ojousima/thesis/thesis.tex

%%%%%%%%%%%%%%%%%%%%%%%%%%%%%%%%%%%%%%%%%%%%%%%%%%%%%%%%%%%%%%%%%%%%
%%%%%%%%%%%%%%%%%%%%%%%%%%%%%%%%%%%%%%%%%%%%%%%%%%%%%%%%%%%%%%%%%%%%
%%                                                                %%
%% An example for writting your thesis using LaTeX                %%
%% Original version by Luis Costa,  changes by Perttu Puska       %%
%% Support for Swedish added 15092014                             %%
%%                                                                %%
%% This example consists of the files                             %%
%%         thesistemplate.tex (versio 2.01)                       %%
%%         opinnaytepohja.tex (versio 2.01) (for text in Finnish) %%
%%         aaltothesis.cls (versio 2.01)                          %%
%%         kuva1.eps                                              %%
%%         kuva2.eps                                              %%
%%         kuva1.pdf                                              %%
%%         kuva2.pdf                                              %%
%%                                                                %%
%%                                                                %%
%% Typeset either with                                            %%
%% latex:                                                         %%
%%             $ latex opinnaytepohja                             %%
%%             $ latex opinnaytepohja                             %%
%%                                                                %%
%%   Result is the file opinnayte.dvi, which                      %%
%%   is converted to ps format as follows:                        %%
%%                                                                %%
%%             $ dvips opinnaytepohja -o                          %%
%%                                                                %%
%%   and then to pdf as follows:                                  %%
%%                                                                %%
%%             $ ps2pdf opinnaytepohja.ps                         %%
%%                                                                %%
%% Or                                                             %%
%% pdflatex:                                                      %%
%%             $ pdflatex opinnaytepohja                          %%
%%             $ pdflatex opinnaytepohja                          %%
%%                                                                %%
%%   Result is the file opinnaytepohja.pdf                        %%
%%                                                                %%
%% Explanatory comments in this example begin with                %%
%% the characters %%, and changes that the user can make          %%
%% with the character %                                           %%
%%                                                                %%
%%%%%%%%%%%%%%%%%%%%%%%%%%%%%%%%%%%%%%%%%%%%%%%%%%%%%%%%%%%%%%%%%%%%
%%%%%%%%%%%%%%%%%%%%%%%%%%%%%%%%%%%%%%%%%%%%%%%%%%%%%%%%%%%%%%%%%%%%

%% Uncomment one of these:
%% the 1st when using pdflatex, which directly typesets your document in
%% pdf (use jpg or pdf figures), or
%% the 2nd when producing a ps file (use eps figures, don't use ps figures!).
\documentclass[english,12pt,a4paper,pdftex,elec,utf8]{aaltothesis}
%\documentclass[english,12pt,a4paper,dvips]{aaltothesis}

%% To the \documentclass above
%% specify your school: arts, biz, chem, elec, eng, sci
%% specify the character encoding scheme used by your editor: utf8, latin1

%% Use one of these if you write in Finnish (see the Finnish template):
%%
%\documentclass[finnish,12pt,a4paper,pdftex,elec,utf8]{aaltothesis}
%\documentclass[finnish,12pt,a4paper,dvips]{aaltothesis}

\usepackage{graphicx}

%% Use this if you write hard core mathematics, these are usually needed
\usepackage{amsfonts,amssymb,amsbsy}

%includes amsmath for EQREF
\usepackage{mathtools}

%% Use the macros in this package to change how the hyperref package below 
%% typesets its hypertext -- hyperlink colour, font, etc. See the package
%% documentation. It also defines the \url macro, so use the package when 
%% not using the hyperref package.
%%
%\usepackage{url}

%% Use this if you want to get links and nice output. Works well with pdflatex.
\usepackage{hyperref}
\hypersetup{pdfpagemode=UseNone, pdfstartview=FitH,
  colorlinks=true,urlcolor=black,linkcolor=black,citecolor=black,
  pdftitle={Energy Harvester Design for Intelligent Tyre Systems},pdfauthor={Otso Jousimaa},
  pdfkeywords={Modify keywords}}

%Use for degree symbol
\usepackage{gensymb}

%for color
\usepackage{color}

%for block comments
\usepackage{verbatim}

%for sub/superscripts
\usepackage{fixltx2e}

%for multi-citations
\usepackage{cite}

%% All that is printed on paper starts here
\begin{document}

%% Change the school field to specify your school if the automatically 
%% set name is wrong
% \university{aalto-yliopisto}
\university{Aalto University}
% \school{Sähkötekniikan korkeakoulu}
\school{School of Electrical Engineering}

%% Only for B.Sc. thesis: Choose your degree programme. 
%\degreeprogram{Electronics and electrical engineering}
%%

%% ONLY FOR M.Sc. AND LICENTIATE THESIS: Specify your department,
%% professorship and professorship code. 
%%
\department{Department of Electrical Engineering and Automation}
\professorship{Automation technology \hfill Code: AS-84}
%%

%% Valitse yksi näistä kolmesta
%%
%% Choose one of these:
%\univdegree{BSc}
\univdegree{MSc}
%\univdegree{Lic}

%% Your own name (should be self explanatory...)
\author{Otso Jousimaa}

%% Your thesis title comes here and again before a possible abstract in
%% Finnish or Swedish . If the title is very long and latex does an
%% unsatisfactory job of breaking the lines, you will have to force a
%% linebreak with the \\ control character. 
%% Do not hyphenate titles.
%% 
\thesistitle{Energy Harvester Design for Intelligent Tyre Systems}

\place{Espoo}

%% For B.Sc. thesis use the date when you present your thesis. 
%% 
%% Kandidaatintyön päivämäärä on sen esityspäivämäärä! 
\date{14.03.2016}

%% B.Sc. or M.Sc. thesis supervisor 
%% Note the "\" after the comma. This forces the following space to be 
%% a normal interword space, not the space that starts a new sentence. 
%% This is done because the fullstop isn't the end of the sentence that
%% should be followed by a slightly longer space but is to be followed
%% by a regular space.
%%
\supervisor{Prof.\ Arto Visala}

%% B.Sc. or M.Sc. thesis advisors(s). You can give upto two advisors in
%% this template. Check with your supervisor how many official advisors
%% you can have.
%%
%\advisor{Prof.\ Pirjo Professori}
\advisor{M.Sc.\ Yi Xiong}
\advisor{D.Sc.\ (Tech.) Ari Tuononen}

%% Aalto logo: syntax:
%% \uselogo{aaltoRed|aaltoBlue|aaltoYellow|aaltoGray|aaltoGrayScale}{?|!|''}
%%
%% Logo language is set to be the same as the document language.
%% Logon kieli on sama kuin dokumentin kieli
%%
\uselogo{aaltoRed}{''}

%% Create the coverpage
%%
\makecoverpage

%% Note that when writting your master's thesis in English, place
%% the English abstract first followed by the possible Finnish abstract

%% English abstract.
%% All the information required in the abstract (your name, thesis title, etc.)
%% is used as specified above.
%% Specify keywords
%%
%% Kaikki tiivistelmässä tarvittava tieto (nimesi, työnnimi, jne.) käytetään
%% niin kuin se on yllä määritelty.
%% Avainsanat
%%
\keywords{Energy harvesting, tyre sensors, active safety systems}
%% Abstract text
\begin{abstractpage}[english]
Modern tyres can have sensor systems which require energy. Currently these systems are powered by batteries, which limit the power available and lifetime of the systems. This study presents an energy harvester system to power such sensor systems. Piezoelectric and electromagnetic harvester designs are 
presented and the piezoelectric harvester design was selected for use in the tyre. Electrical energy was harvested from tyre rotation and deformation, harvested power was rectified and stored into a supercapacitor at a voltage level usable by modern microcontrollers. Tens of milliwatts of electrical power was obtained from both harvesters in a vibration exciter test setup, and the piezoelectric harvester produced 13 microwatts of electrical power in a chassis dynamometer test rig. Further testing indicates 50 microwatts of power is obtainable at a higher speed of the tyre. The power obtained from harvester exceeds sleep mode power requirement of sensor system, and the sensor system could be theoretically operated intermittently with the power available from harvester. Continuous operation of a sensor system is not feasible with the presented harvester.
\end{abstractpage}

%% Force a new page so that the possible English abstract starts on a new page
%%
%% Pakotetaan uusi sivu varmuuden vuoksi, jotta 
%% mahdollinen suomenkielinen ja englanninkielinen tiivistelmä
%% eivät tule vahingossakaan samalle sivulle
\newpage
%
%% Abstract in Finnish.  Delete if you don't need it. 
\thesistitle{Energy Harvester Design for Intelligent Tire Systems}
\advisor{DI Yi Xiong}
\advisor{TkT Ari Tuononen}
\degreeprogram{Automaatio- ja systeemitekniikka}
\department{Sähkötekniikan ja automaation laitos}
\professorship{Automaatiotekniikka \hfill Koodi: AS-84}
%% Avainsanat
\keywords{Energian harvestointi, rengasanturit, aktiiviset turvajärjestelmät}
%% Tiivistelmän tekstiosa
\begin{abstractpage}[finnish]
Moderneissa renkaissa voi olla anturijärjestelmiä jotka tarvitsevat energiaa. Nykyään nämä järjestelmät saavat tehonsa pattereista, mikä 
rajoittaa käytettävissä olevaa tehoa ja järjestelmän käyttöaikaa.
Tässä työssä esitetään energianharvestointijärjestelmä rengasantureiden tarpeisiin.  

Työssä esitetään pietsosähköinen ja sähkömagneettinen harvesteri, joista pietsosähköinen harvesteri todettiin paremmin renkaaseen soveltuvaksi. Sähköistä energiaa kerättiin renkaan pyörimisliikkeestä ja muodonmuutoksista. Kerätty energia tasasuunnattiin ja varastoitiin superkapasitoriin modernille mikrokontrollerille soveltuvalla jännitetasolla. Molemmat harvesterit tuottivat kymmeniä milliwatteja tärinägeneraattorilla testattuna ja pietsosähköinen harvesteri tuotti 13 mikrowattia dynamometrialustalla. Myöhempi testaus ennustaa että pietsosähköinen generaattori voisi tuottaa 50 mikrowattia tehoa korkeammilla rengasnopeuksilla. 

Harvesterista saatu teho ylittää anturijärjestelmän lepovirran kulutuksen, ja anturijärjestelmää voisi teoriassa käyttää jaksottaisesti käytettävissä olevalla teholla. Anturijärjestelmän jatkuva käyttäminen ei ole mahdollista tässä työssä esitetyllä harvesterilla. 
\end{abstractpage}

%% Preface
%%
%% Esipuhe 
\mysection{Preface}
%\mysection{Esipuhe}
This research was carried out in the Laboratory of Vehicle Technology, Aalto University School of Engineering during 2015-2016. 
Some sections of the work relating to piezoelectric harvester and electronics design have been used as a basis for IEEE Intelligent Vehicles Symposium 2016 
conference paper pending peer review.   

I am deeply grateful for my thesis instructors M.Sc Yi Xiong and D.Sc Ari Tuononen for their encouragement, guidance and patience in all phases of the work. 
Special thanks go to my supervisor Prof. Arto Visala for his confidence in me and my supervisors during the work. 

I would like to express my gratitude to Daniel Edwards, Lauri Jämsä, Tero Kapanen, Gaja Kochaniewicz, Martti Paalanen, Markku Rouvala and Heikki Salminen for providing insights in use cases, manufacturing methods, soundness of various ideas and textual clarity for the work.  

The work was financially supported by Henry Ford S\"a\"ati\"o

\vspace{5cm}
Otaniemi, 14.03.2016

\vspace{5mm}
{\hfill Otso J. Jousimaa \hspace{1cm}}

%% Force new page after preface
%%
%% Pakotetaan varmuuden vuoksi esipuheen jälkeinen osa
%% alkamaan uudelta sivulta
\newpage

%% Table of contents. 
\thesistableofcontents

%% Symbols and abbreviations
\mysection{Symbols and abbreviations}

\subsection*{Symbols}

\begin{tabular}{ll}
$\mathbf{A}$  & area \\
$\mathbf{B}$  & magnetic flux density  \\
$\varepsilon$ & electromotive force \\
$\mathbf{F}$  & mechanical force \\
g             & gram \\
$g$           & acceleration of falling \\ 
gf            & gram-force \\
$\mathbf{I}$  & electrical current \\
$\mathbf{l}$  & length \\
$\Phi_{B}$    & magnetic flux through a loop area \\
$\rho$        & resistivity \\
$\mathbf{P}$  & power \\
$\mathbf{p}$  & pressure \\
$\mathbf{U}$  & input to system \\
$\mathbf{V}$  & voltage \\
$\mathbf{Y}$  & output from system \\
$\mathbf{Z}$  & complex impedance
\end{tabular}

\subsection*{Abbreviations}

\begin{tabular}{ll}
AC         & Alternating Current \\
BLE        & Bluetooth Low Energy \\
DC         & Direct Current \\
EMF        & Electromotive Force \\
FEA        & Finite Element Analysis \\
I2C        & Inter-Integrated Circuit \\
IC         & Integrated Circuit \\
LG         & Linear Generator \\
MEMS       & Microelectromechanical Systems \\
MOSFET     & Metal–Oxide–Semiconductor Field-Effect Transistor \\
MPPT       & Maximum Power Point Tracking \\
PV         & Photovoltaic \\
RF         & Radio Frequency \\
SPI        & Serial Peripheral Interface \\
SMPS       & Switch-Mode Power Supply \\
TPMS       & Tyre Pressure Monitoring Sensor \\
UART       & Universal Asynchronous Receiver/Transmitter
\end{tabular}

%% Tweaks the page numbering to meet the requirement of the thesis format:
%% Begin the pagenumbering in Arabian numerals (and leave the first page
%% of the text body empty, see \thispagestyle{empty} below).
%% Additionally, force the actual text to begin on a new page with the 
%% \clearpage command.
%% \clearpage is similar to \newpage, but it also flushes the floats (figures
%% and tables).
%% There is no need to change these
%%
\cleardoublepage
\storeinipagenumber
\pagenumbering{arabic}
\setcounter{page}{1}

%% Text body begins. Note that since the text body
%% is mostly in Finnish the majority of comments are
%% also in Finnish after this point. There is no point in explaining
%% Finnish-language specific thesis conventions in English. Someday 
%% this text will possibly be translated to English.
%%
%\section{Introduction}
\input{introduction.tex}

%\section{Background}
%% In a thesis, every section starts a new page, hence \clearpage
\clearpage
\input{background.tex}

%\section{Literature review?}
%\input{Literature review?}

%\section{Design} Theoretical
\clearpage
\input{design.tex}

%\section{Results} Practical
\clearpage
\input{results.tex}

%\section{Conclusions}
\clearpage
\input{conclusions.tex}

%% L\"ahdeluettelo
%%
%% \phantomsection varmistaa, ett\"a hyperref-paketti latoo hypertekstilinkit
%% oikein.
%%
%% The \phantomsection command is nessesary for hyperref to jump to the 
%% correct page, in other words it puts a hyper marker on the page.
\clearpage
\phantomsection
\addcontentsline{toc}{section}{\refname}
%\addcontentsline{toc}{section}{References}
\bibliography{library}
\bibliographystyle{IEEEtran}

%% Appendices
%% Liitteet
\clearpage

\thesisappendix

\end{document}
