ojousima/thesis/hardware/BQ25504/bq25504_Design_Help_V1_2.ods

User Input | VBIAS | 1.25 | V
Fixed
 | Comparator threshold for VSTOR maximum. |  |  |  |  | Comparator threshold voltages indicating when |  |  |  |  | Comparator threshold for VSTOR minimum. |  |  |  |  | Maximum power point threshold, e.g. ~0.7-0.8 of
 | Typically the max storage element voltage, |  |  |  |  | VSTOR has risen above VBAT_OK_HYS or fallen |  |  |  |  | Typically the min storage element voltage, |  |  |  |  | solar panel's open circuit voltage
 | e.g. 4.2V for LiIon battery |  |  |  |  | below VBAT_OK |  |  |  |  | e.g. 2.5V for LiIon battery
 | 2.5V < VBAT_OV < 5.25V |  |  |  |  | VBAT_OV > VBAT_OK_HYST > VBAT_UV |  |  |  |  | 2.2V < VBAT_UV < VBAT_OV |  |  |  |  | MPPT
Desired |  |  |  |  |  | RSUM1 | 10 | Mohm |  |  |  |  |  |  |  | RSUM1 | 10 | Mohm
Desired | RSUM1 | 10 | Mohm |  |  | VBAT_OK | 2.4 | V | > VBAT_UV |  | RSUM1 | 10 | Mohm |  |  | VIN_DC(OC) | 1 | V | Open Circuit Volts
Desired | VBAT_OV | 3.5 | V |  |  | VBAT_OK_HYST | 2.9 | V | > VBAT_OK |  | VBAT_UV | 2.2 | V |  |  | VREF_SAMP | 0.8 | V | MPP voltage
 |  |  |  |  |  |  |  | closest 1% resistor1 |  |  |  |  |  |  |  |  |  | closest 1% resistor1
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
