ojousima/thesis/hardware/BQ25504/bq25504/picture.PNG

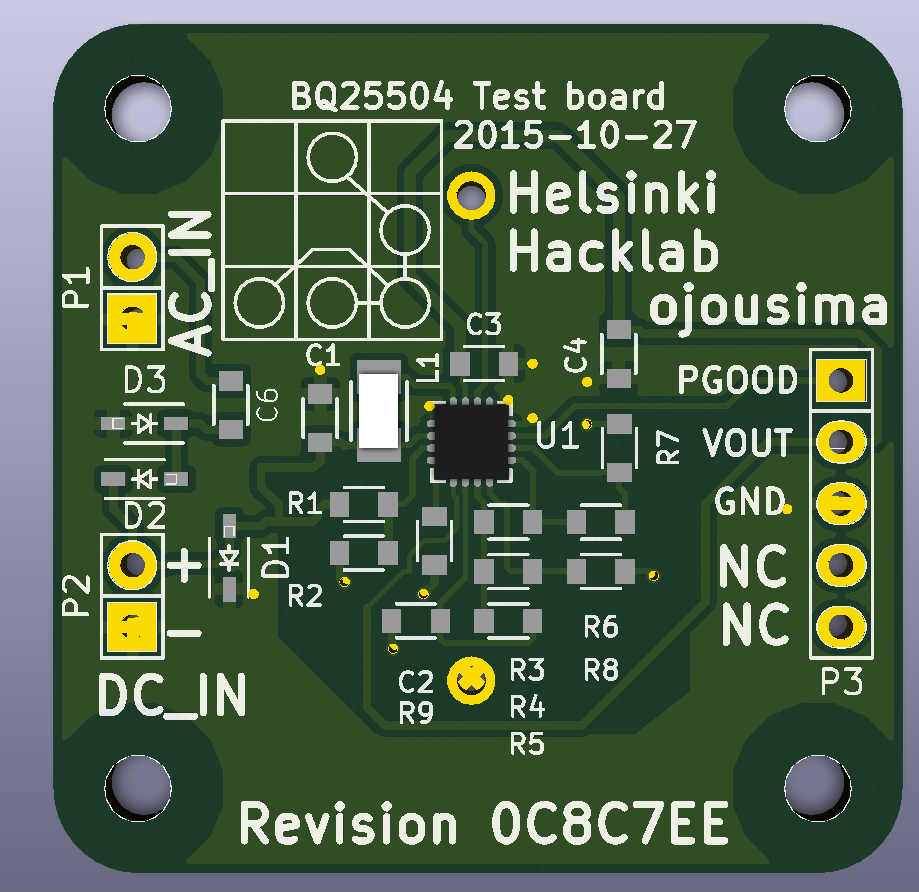
hardware/BQ25504/bq25504/picture.PNG
