ojousima/thesis/images/80kmh_timedomain.jpg

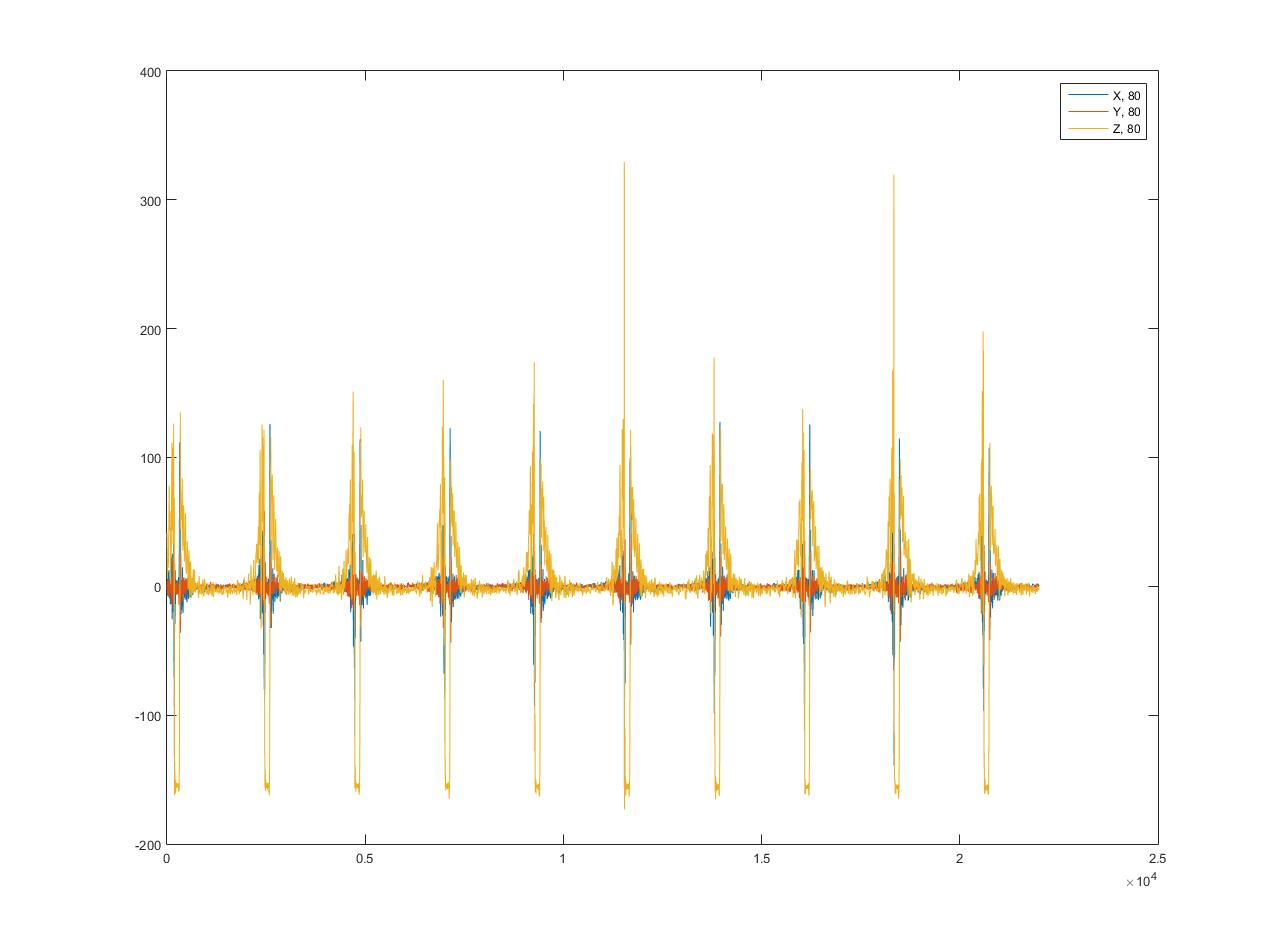
images/80kmh_timedomain.jpg
