ojousima/thesis/images/80kmh_timedomain_onerotation.jpg

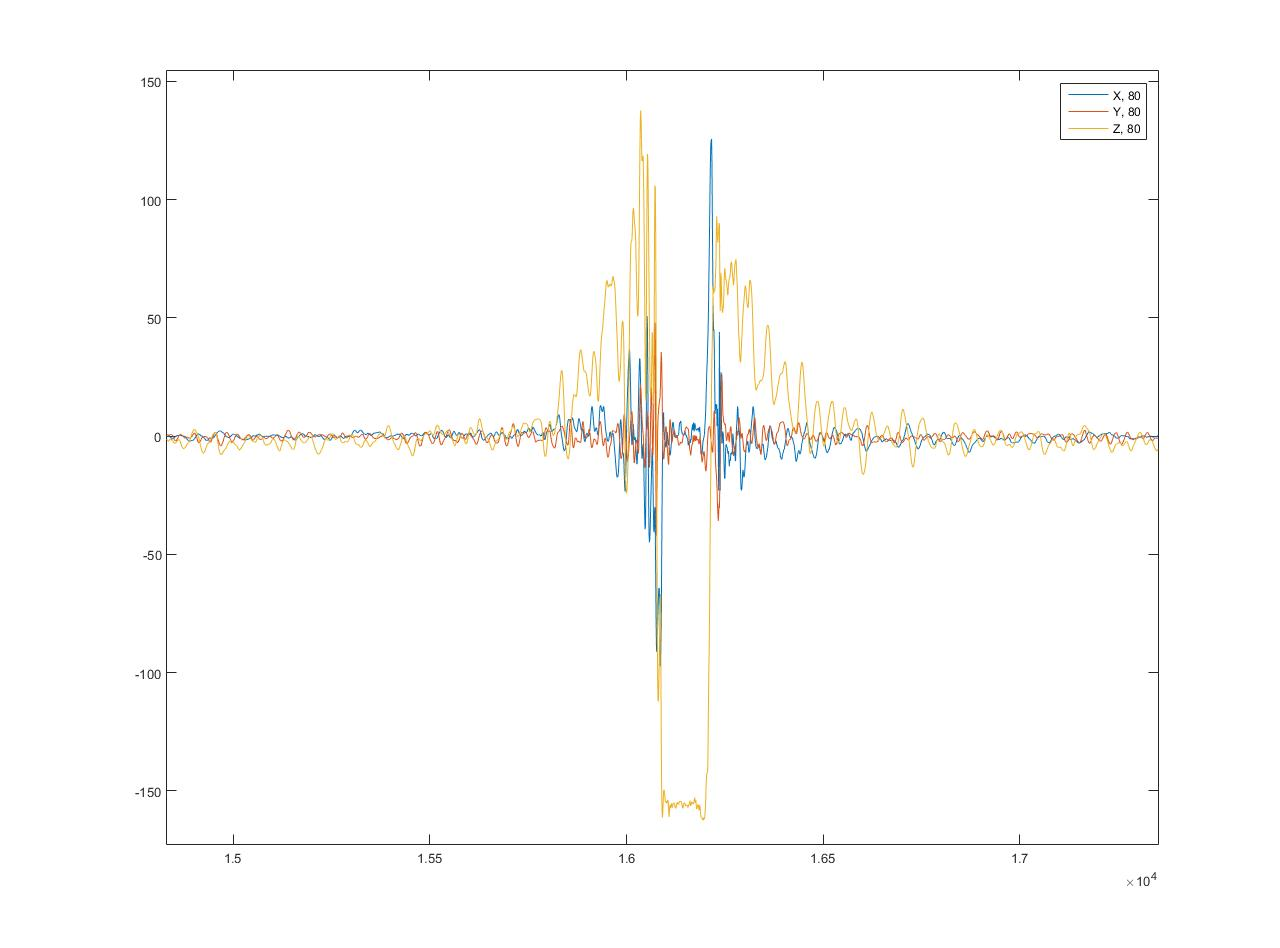
images/80kmh_timedomain_onerotation.jpg
