ojousima/thesis/images/FFT-20-zoom.jpg

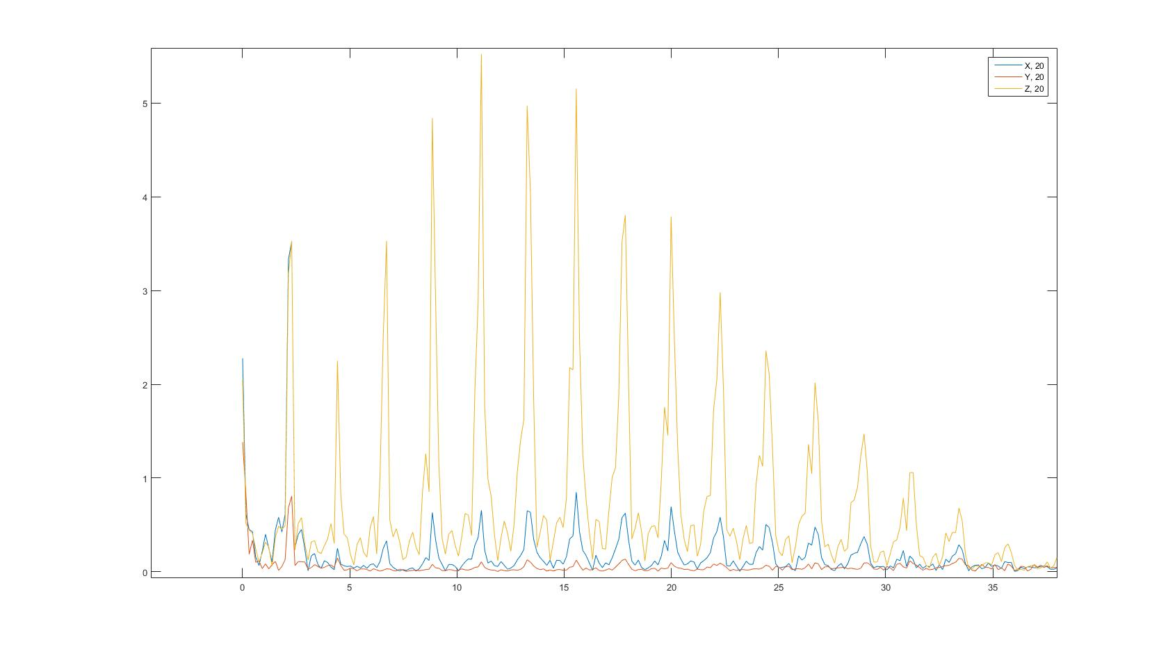
images/FFT-20-zoom.jpg
