ojousima/thesis/images/FFT-20.jpg

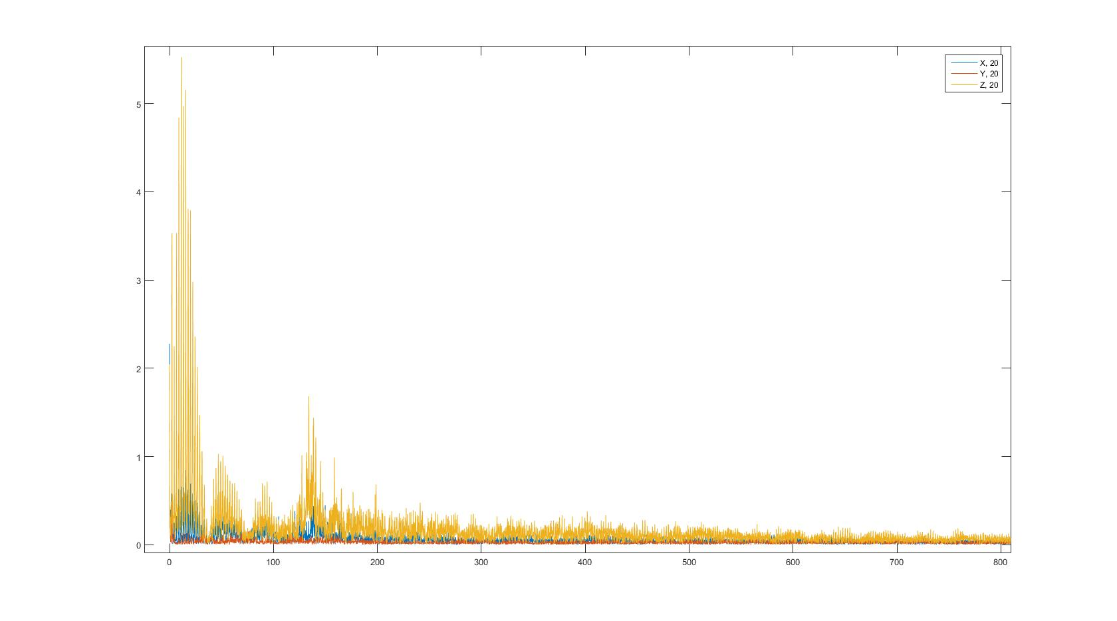
images/FFT-20.jpg
