ojousima/thesis/images/FFT-80-zoom.jpg

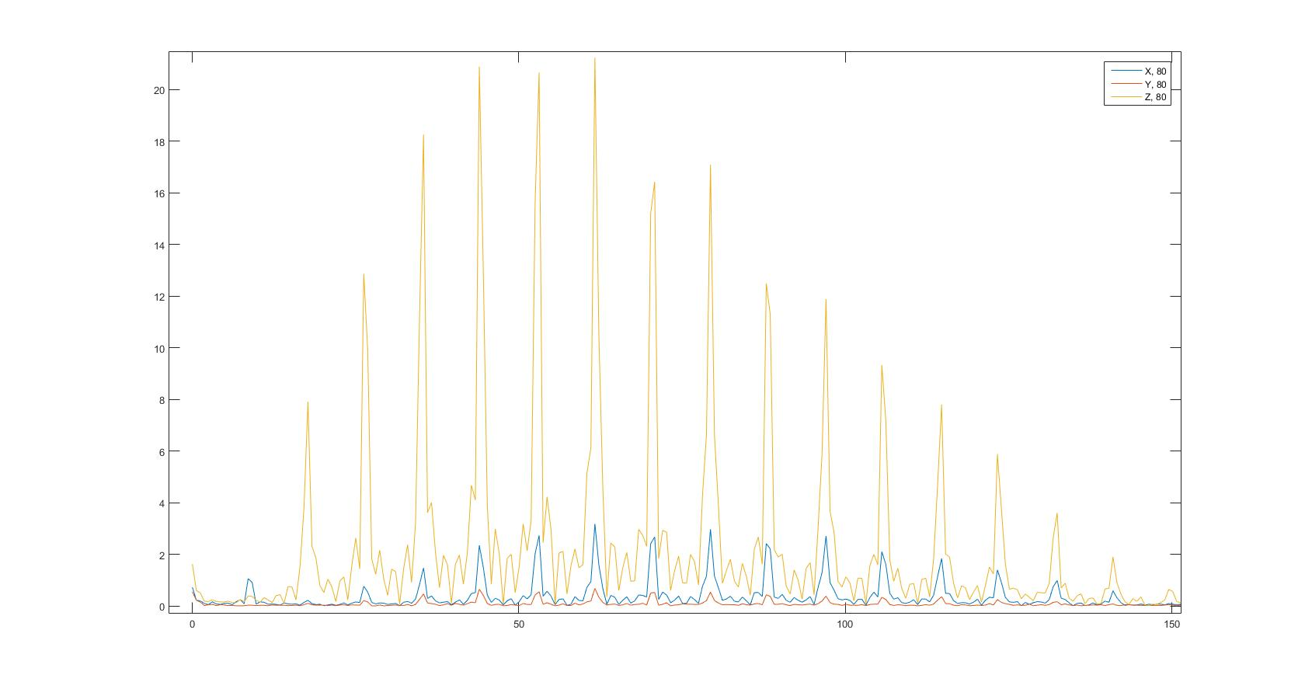
images/FFT-80-zoom.jpg
