ojousima/thesis/images/FFT-80.jpg

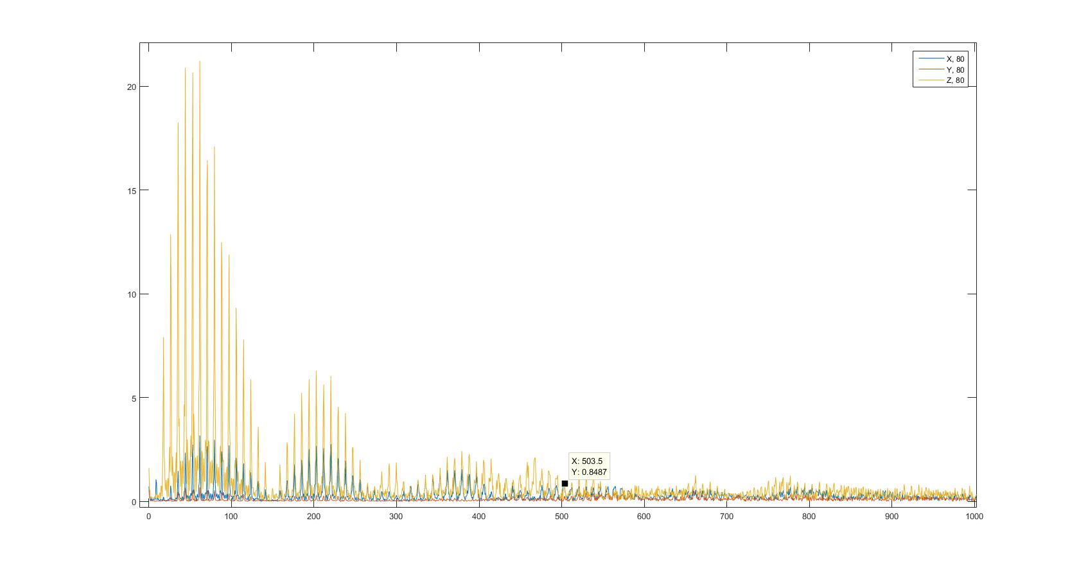
images/FFT-80.jpg
