ojousima/thesis/images/own_dwg/femm__delta_linkage.JPG

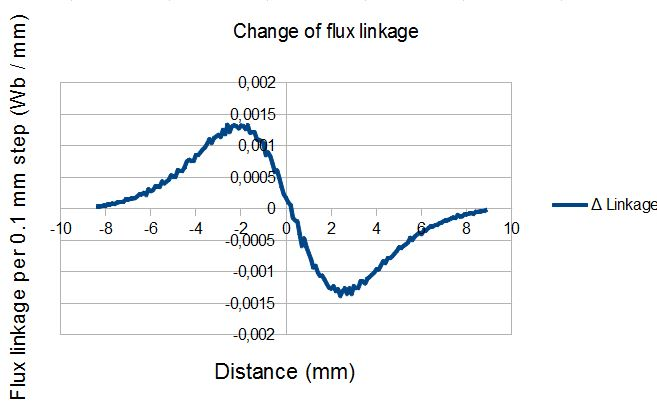
images/own_dwg/femm__delta_linkage.JPG
