ojousima/thesis/images/own_dwg/femm_fvsd.jpg

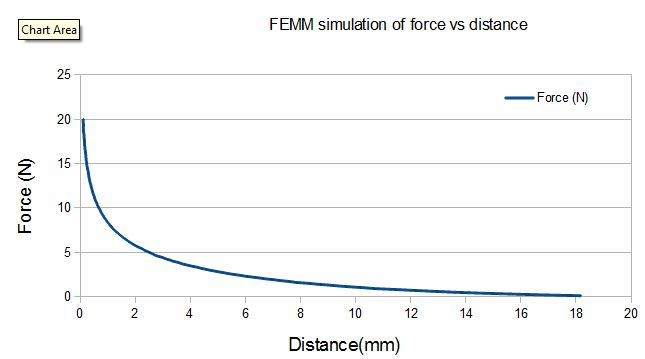
images/own_dwg/femm_fvsd.jpg
