ojousima/thesis/images/own_dwg/femm_linkage.JPG

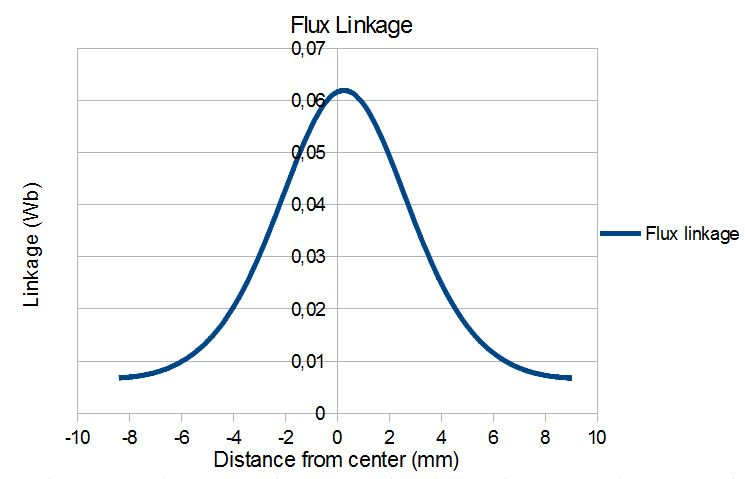
images/own_dwg/femm_linkage.JPG
