ojousima/thesis/images/own_dwg/ltspice_piezo_power.jpg

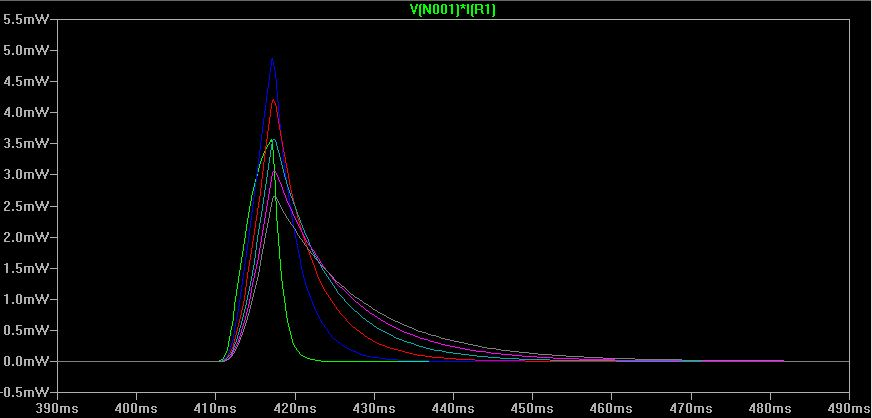
images/own_dwg/ltspice_piezo_power.jpg
