ojousima/thesis/images/own_dwg/ltspice_piezo_voltage.jpg

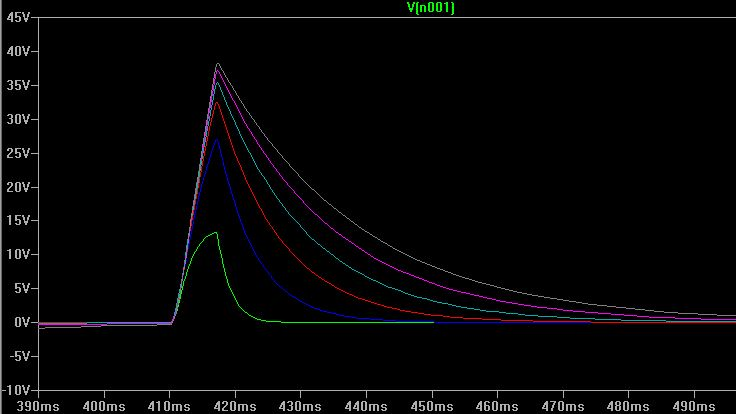
images/own_dwg/ltspice_piezo_voltage.jpg
