ojousima/thesis/images/own_dwg/magnet_tube_model.jpg

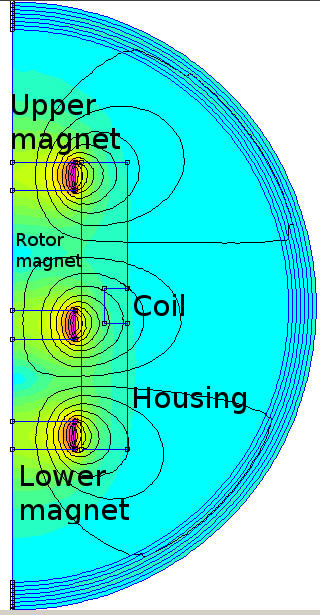
images/own_dwg/magnet_tube_model.jpg
