ojousima/thesis/images/own_dwg/simulation/voltage_doubler.jpg

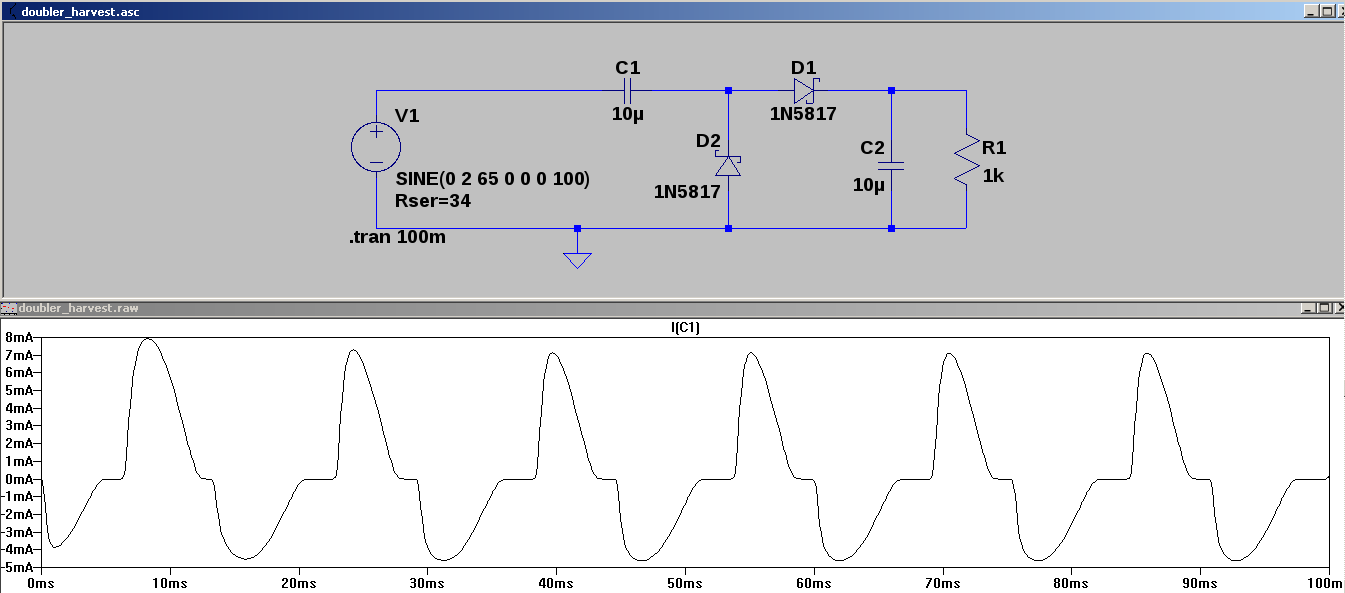
images/own_dwg/simulation/voltage_doubler.jpg
