ojousima/thesis/images/own_dwg/simulink.jpg

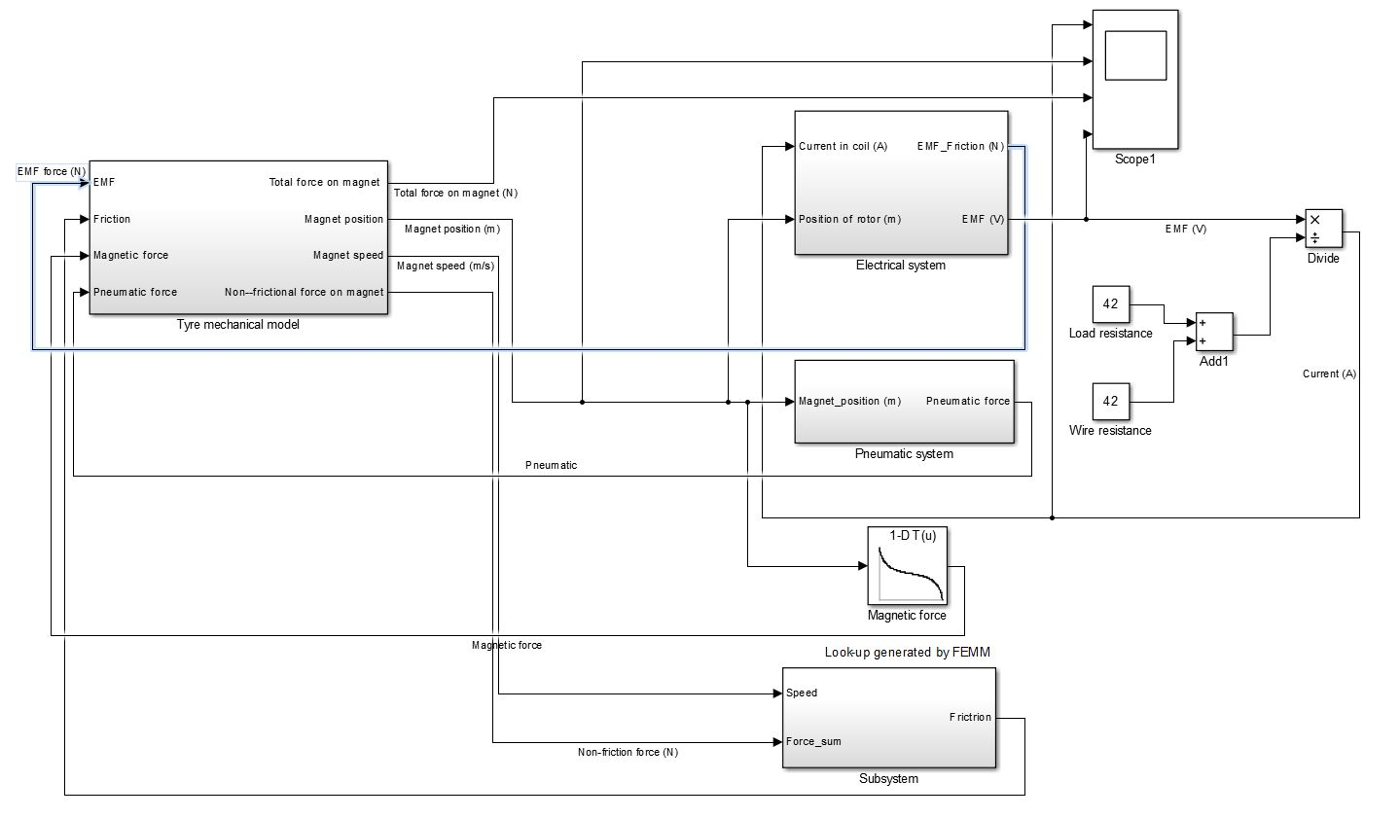
images/own_dwg/simulink.jpg
