ojousima/thesis/images/own_dwg/simulink_waveforms.jpg

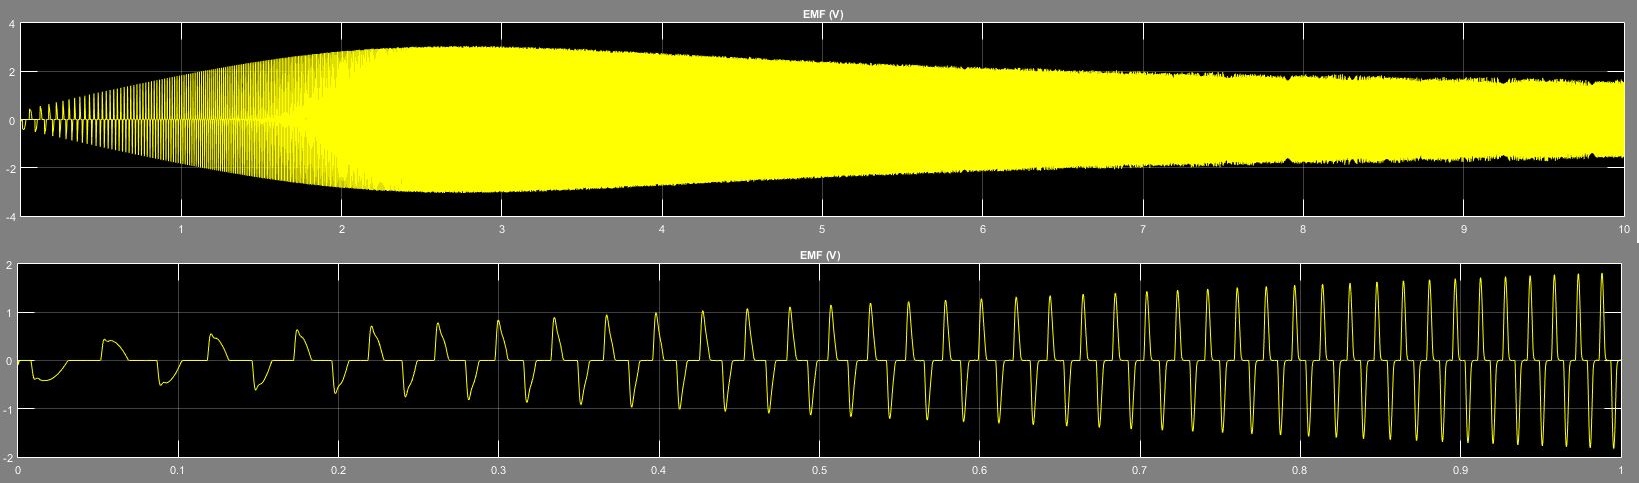
images/own_dwg/simulink_waveforms.jpg
