ojousima/thesis/images/own_pic/pcb.jpg

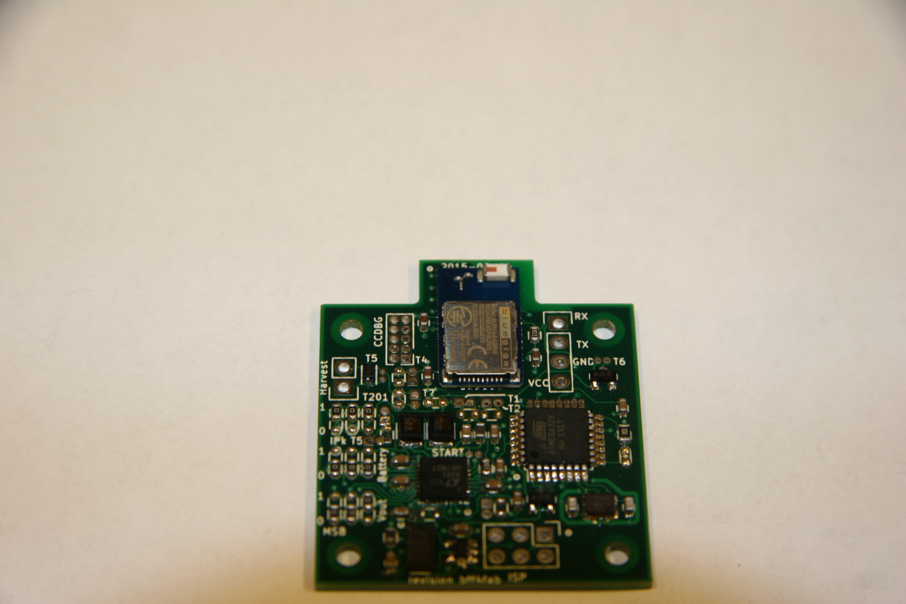
images/own_pic/pcb.jpg
