ojousima/thesis/images/own_pic/piezo_harvester.jpg

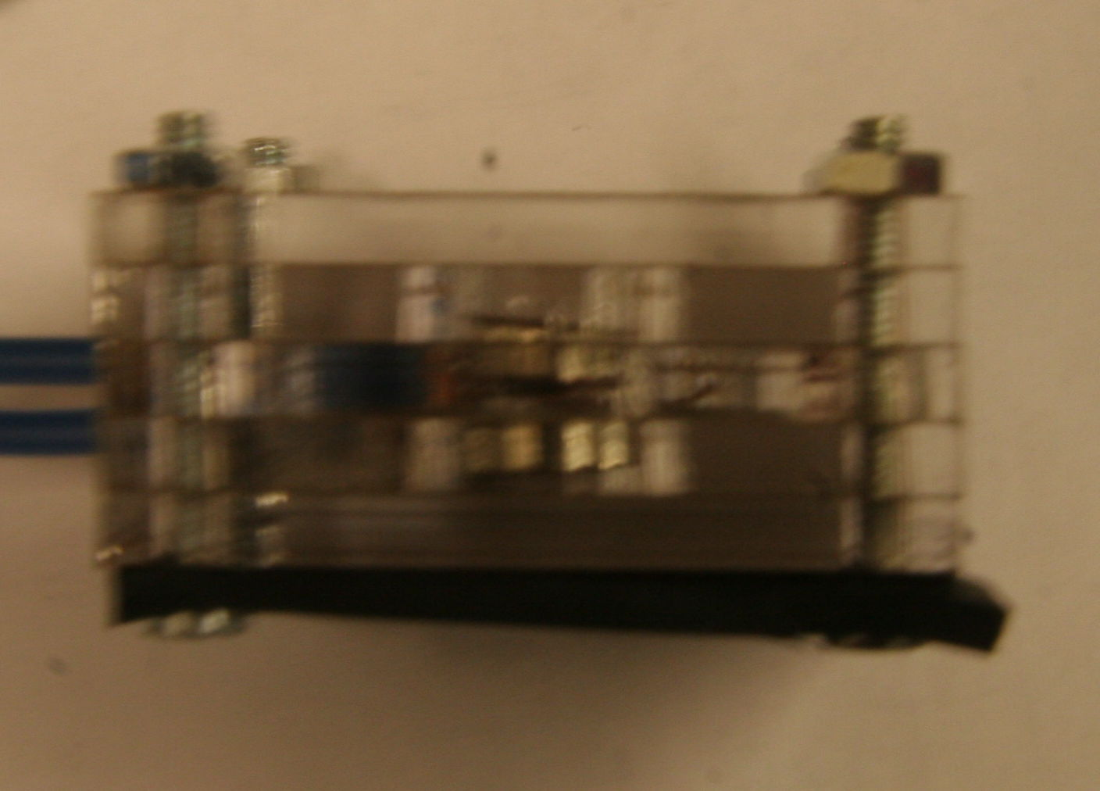
images/own_pic/piezo_harvester.jpg
