ojousima/thesis/images/own_pic/tyre_fixture/piezo_bq_mount2.jpg

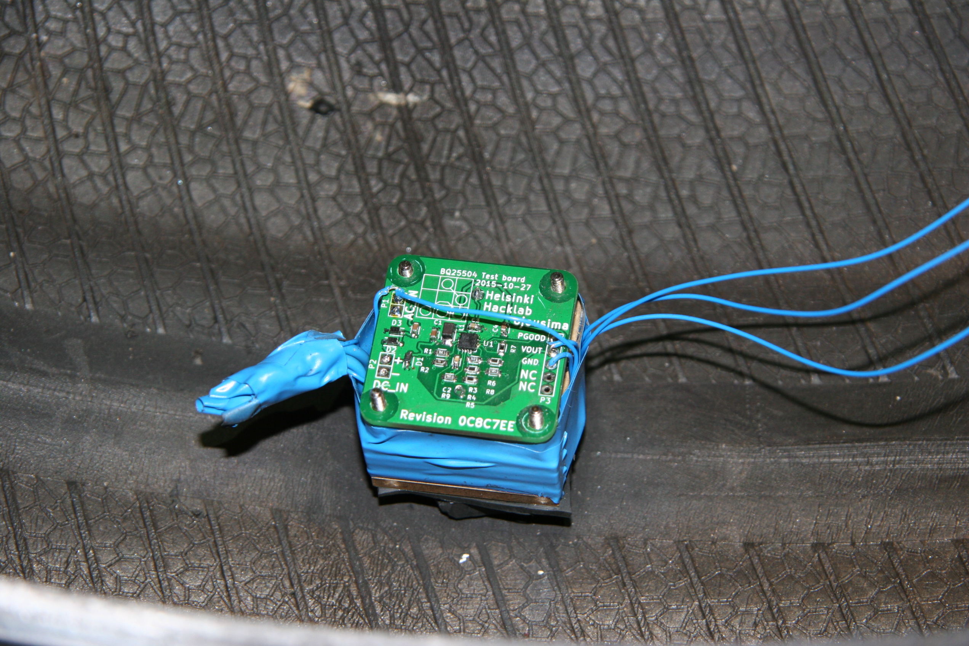
images/own_pic/tyre_fixture/piezo_bq_mount2.jpg
