ojousima/thesis/images/own_pic/tyre_fixture/supercap_break.JPG

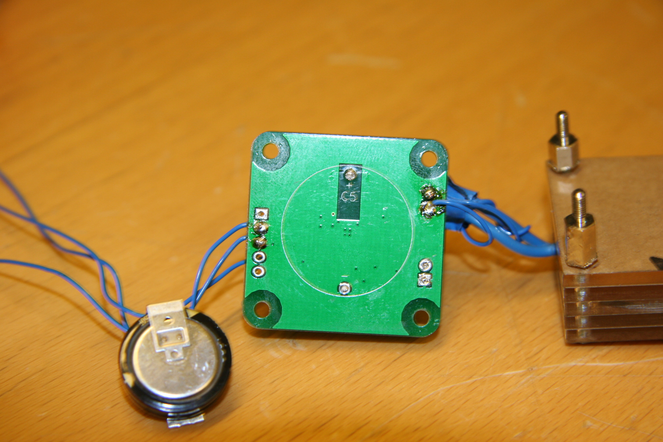
images/own_pic/tyre_fixture/supercap_break.JPG
