ojousima/thesis/images/raw_matlab/simulated_frequencyresponse.jpg

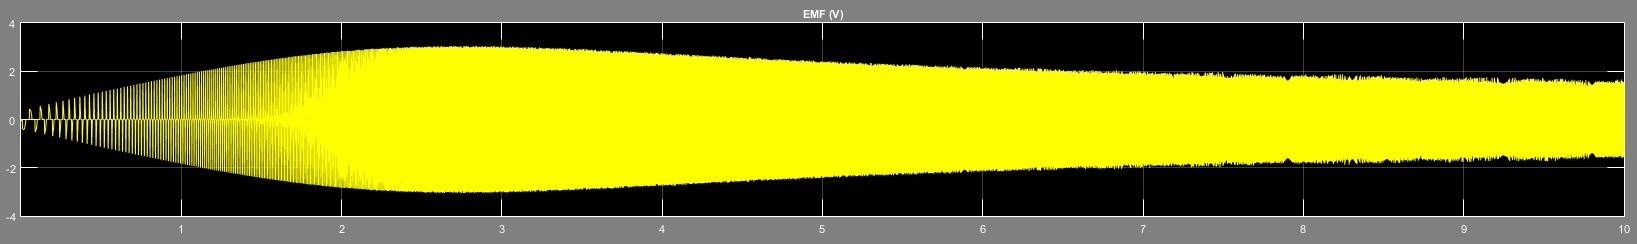
images/raw_matlab/simulated_frequencyresponse.jpg
