ojousima/thesis/images/raw_matlab/simulated_waveform.jpg

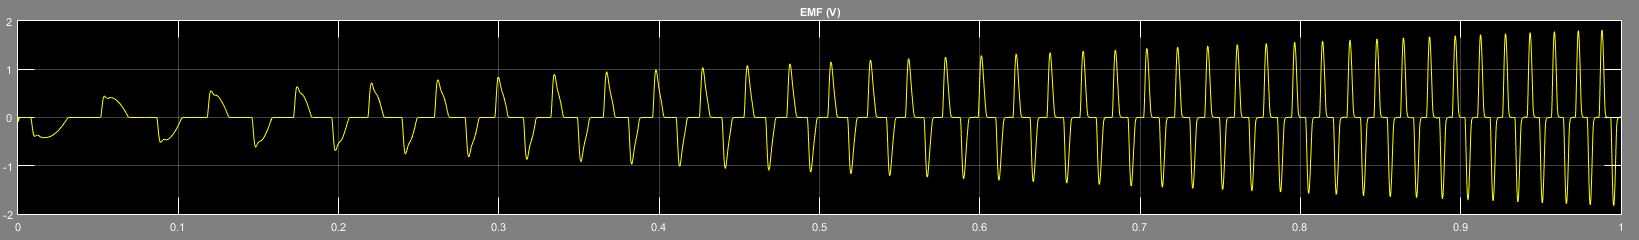
images/raw_matlab/simulated_waveform.jpg
