ojousima/thesis/simulation/FEMM/imgout/cylinder_bias.gif

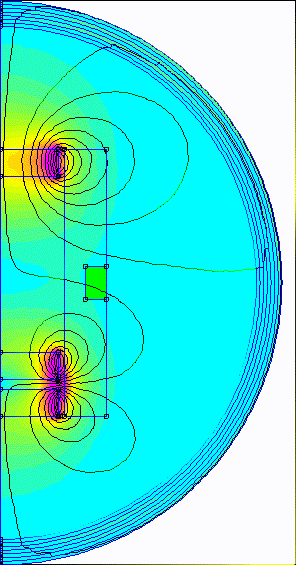
simulation/FEMM/imgout/cylinder_bias.gif
