ojousima/thesis/images/own_pic/shaker_setup/piezo_shaker.jpg

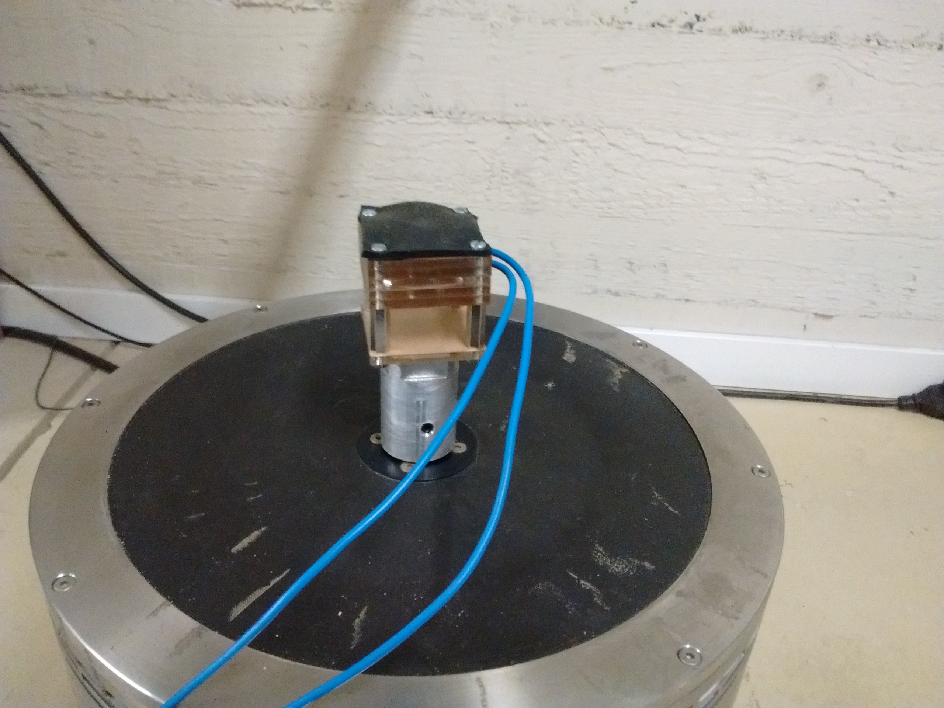
images/own_pic/shaker_setup/piezo_shaker.jpg
