ojousima/thesis/measurements/piezo_force_voltage.ods

Load resistance (k ohm) | Impact force (gf) | Peak voltage (V) | RMS voltage (mV) | Volt*seconds (Vs) | Voltage halving time (ms) |  | Peak power (mW) | Charge transfer (uC) | Capacitance calculated from RC-time (nF) | Energy assuming 39nF capacitor (nJ)
Open (infinity) | 50 | 0.5 | 0.442
Open (infinity) | 150 | 1.8 | 1.4
Open (infinity) | 250 | 3.6 | 2.9
Open (infinity) | 500 | 8 | 6.02
Open (infinity) | 1000 | 20
Open (infinity) | 2000 | 50
550 | 50 | 0.3 | 0.094 | 0.01 | 10 |  | 0.0001636364 | 1.81818181818182E-005 | 18.1818181818 | 1.755
550 | 150 | 1.08 | 0.42 | 0.0325 | 20 |  | 0.0021207273 | 5.90909090909091E-005 | 36.3636363636 | 22.7448
550 | 250 | 2 | 0.8 | 0.065 | 25 |  | 0.0072727273 | 0.0001181818 | 45.4545454545 | 78
550 | 500 | 6.4 | 3 | 0.23 | 30 |  | 0.0744727273 | 0.0004181818 | 54.5454545455 | 798.72
550 | 1000 | 13.6 | 6.71 | 0.2 | 30 |  | 0.3362909091 | 0.0003636364 | 54.5454545455 | 3606.72
550 | 2000 | 40 |  | 1.6 | 30 |  | 2.9090909091 | 0.0029090909 | 54.5454545455 | 31200
450 | 50 | 0.39 | 0.092 | 0.015 | 15 |  | 0.000338 | 3.33333333333333E-005 | 33.3333333333 | 2.96595
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
