ojousima/thesis/images/own_measurement/circuit/Charging_waveform.png

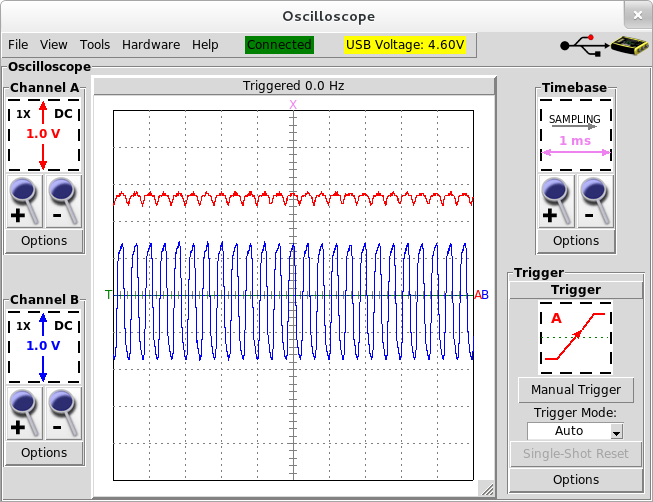
images/own_measurement/circuit/Charging_waveform.png
