ojousima/thesis/images/own_measurement/generator_impact/inductive_2k7.png

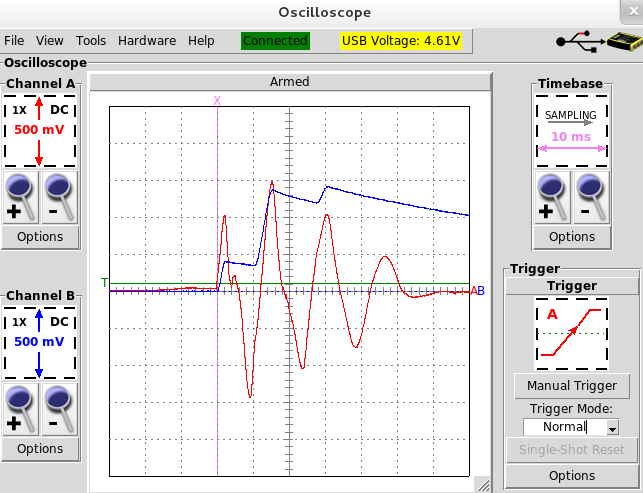
images/own_measurement/generator_impact/inductive_2k7.png
