ojousima/thesis/images/own_measurement/generator_impact/inductive_noload.png

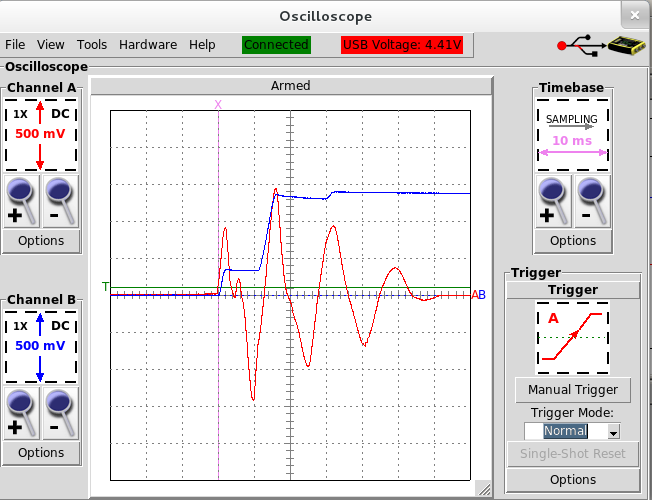
images/own_measurement/generator_impact/inductive_noload.png
