ojousima/thesis/images/own_measurement/generator_impact/inductive_open.png

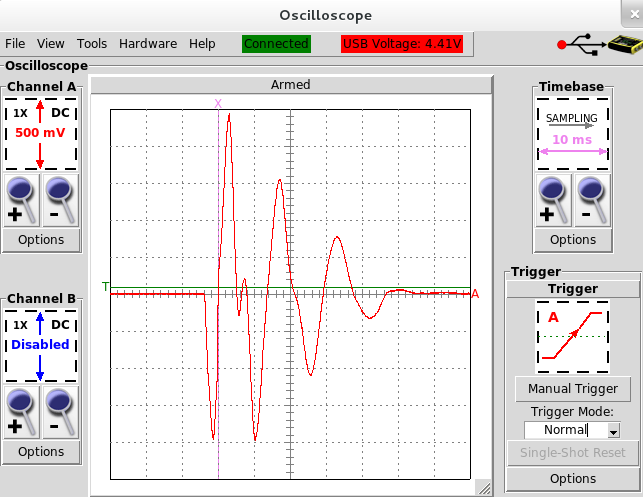
images/own_measurement/generator_impact/inductive_open.png
