ojousima/thesis/images/own_measurement/generator_impact/piezo_noload.png

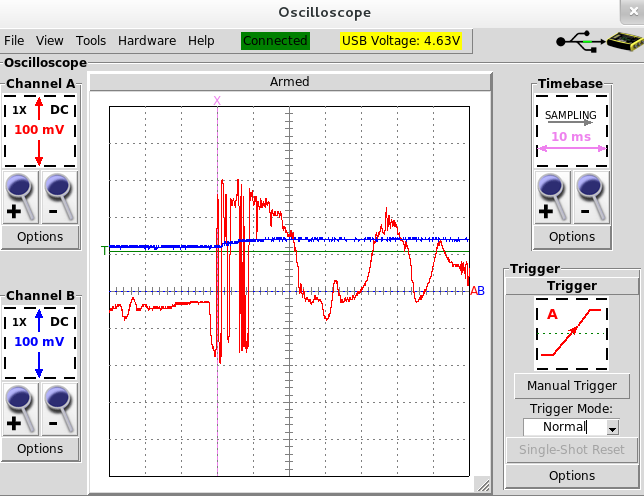
images/own_measurement/generator_impact/piezo_noload.png
