ojousima/thesis/images/own_measurement/generator_shaker/inductive_bode_ferro.png

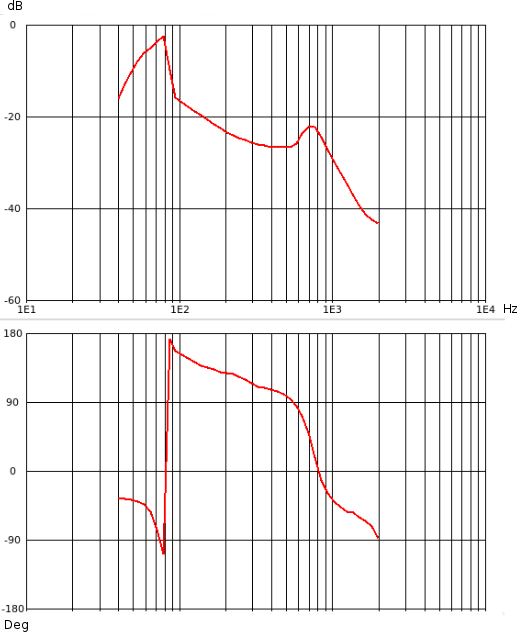
images/own_measurement/generator_shaker/inductive_bode_ferro.png
