ojousima/thesis/images/own_measurement/generator_shaker/inductive_fd_dry.png

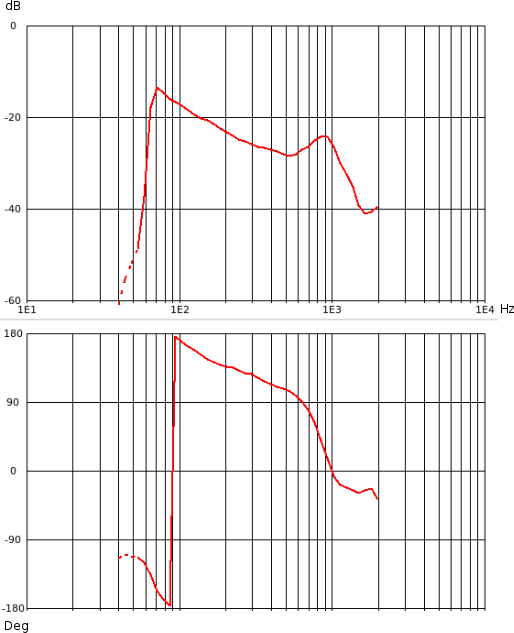
images/own_measurement/generator_shaker/inductive_fd_dry.png
