ojousima/thesis/images/own_measurement/generator_shaker/inductive_fd_open_bode_dry.png

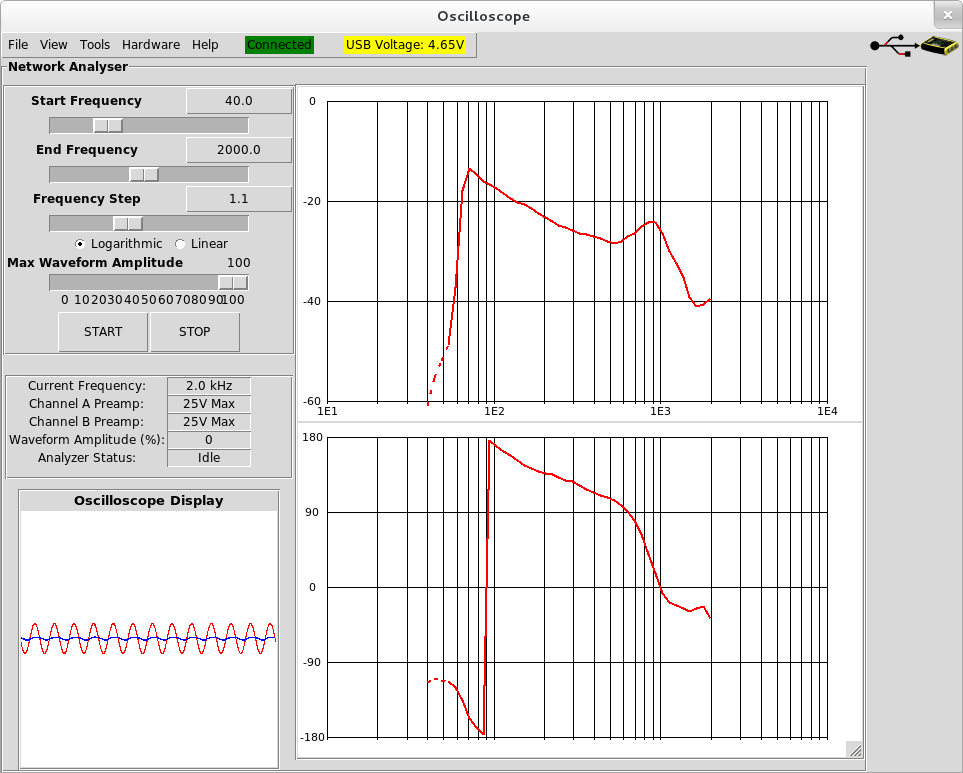
images/own_measurement/generator_shaker/inductive_fd_open_bode_dry.png
