ojousima/thesis/images/own_measurement/generator_shaker/inductive_td_32r_65hz_ferro.png

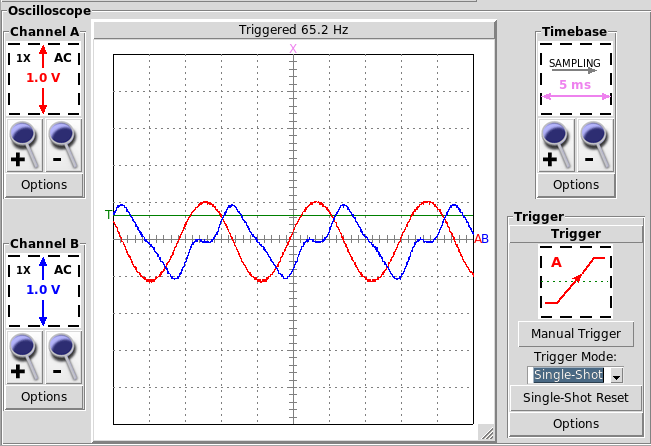
images/own_measurement/generator_shaker/inductive_td_32r_65hz_ferro.png
