ojousima/thesis/images/own_measurement/generator_shaker/piezo_fd_18k_2_2.png

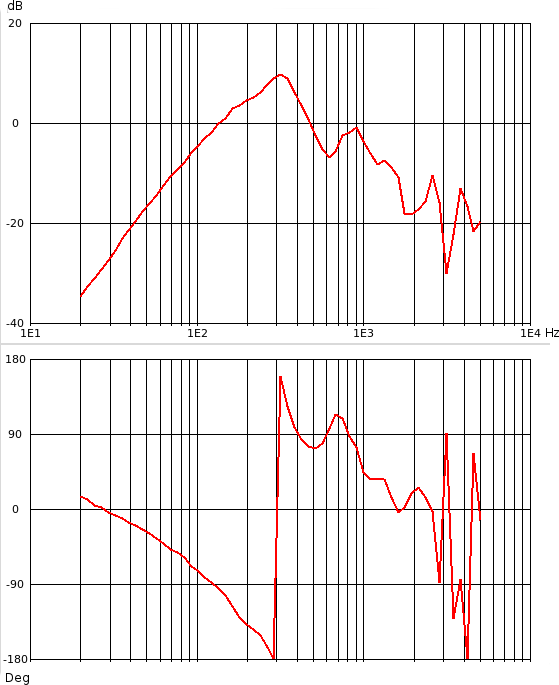
images/own_measurement/generator_shaker/piezo_fd_18k_2_2.png
