ojousima/thesis/images/own_measurement/generator_shaker/piezo_fd_28k_80p_8g.png.png

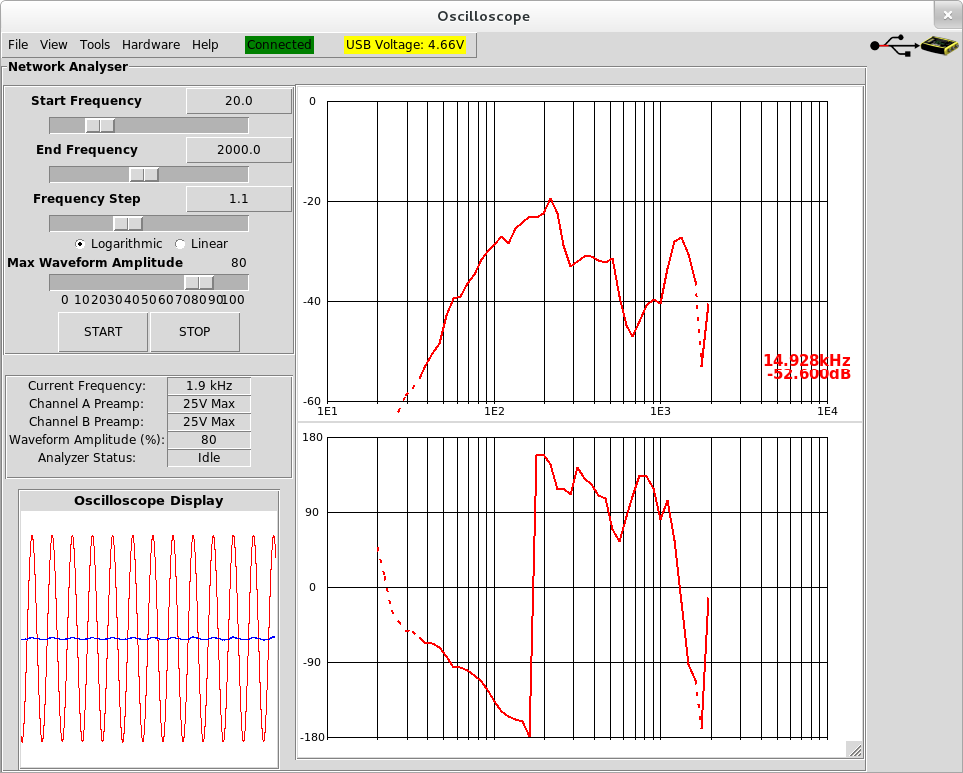
images/own_measurement/generator_shaker/piezo_fd_28k_80p_8g.png.png
