ojousima/thesis/images/own_measurement/generator_shaker/piezo_fd_100k_2.png

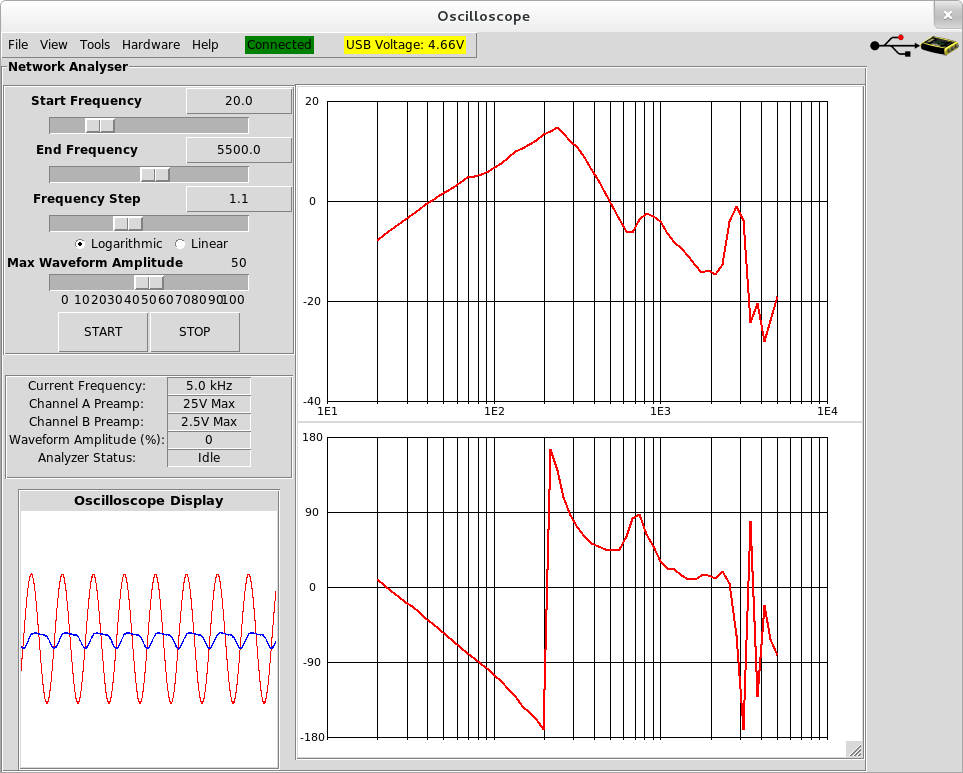
images/own_measurement/generator_shaker/piezo_fd_100k_2.png
