ojousima/thesis/images/own_measurement/generator_shaker/piezo_fd_100k_80p_8g.png

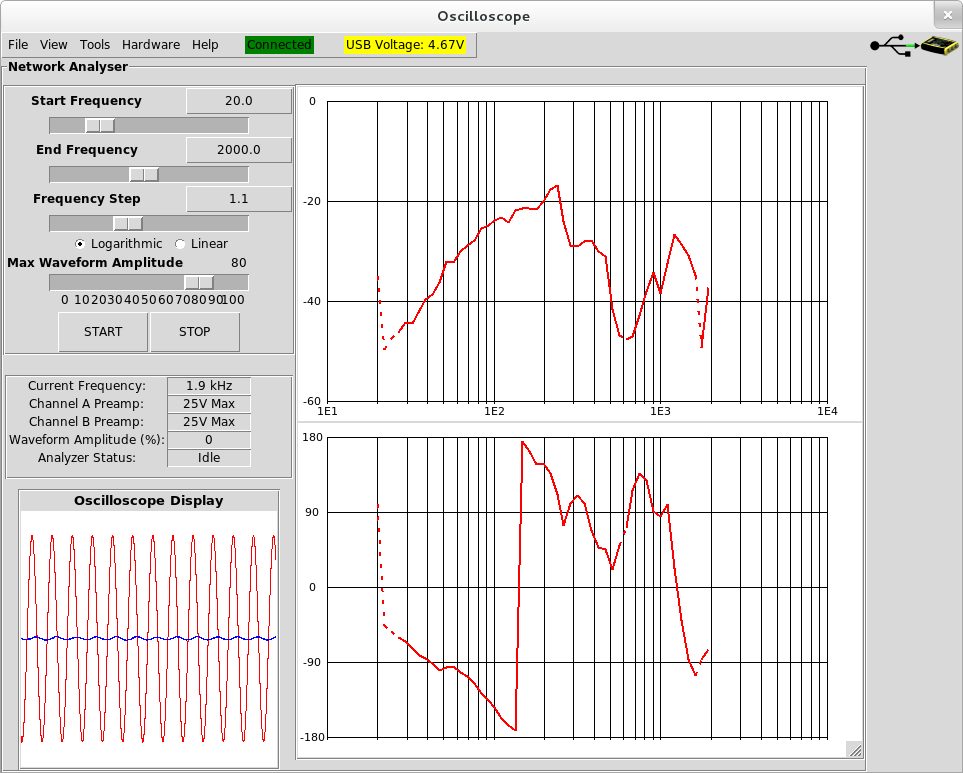
images/own_measurement/generator_shaker/piezo_fd_100k_80p_8g.png
