ojousima/thesis/images/own_measurement/generator_shaker/piezo_fd_open.png

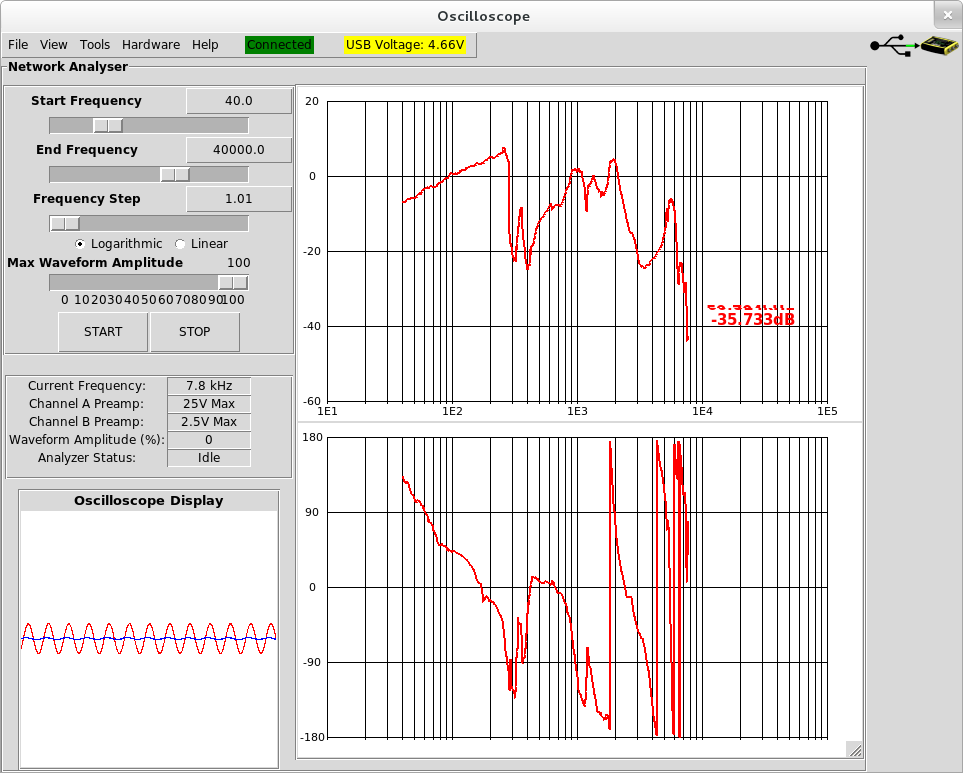
images/own_measurement/generator_shaker/piezo_fd_open.png
