ojousima/thesis/images/own_measurement/generator_shaker/piezo_fd_open_2.png

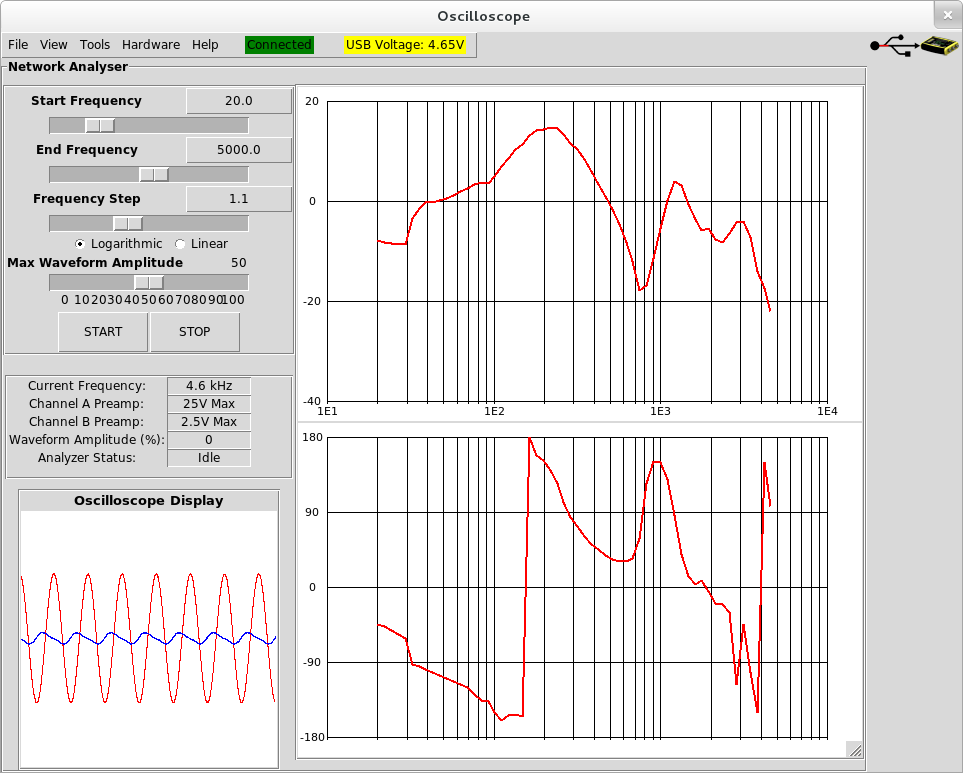
images/own_measurement/generator_shaker/piezo_fd_open_2.png
