ojousima/thesis/images/own_measurement/generator_shaker/piezo_fd_open_80p_8gain.png

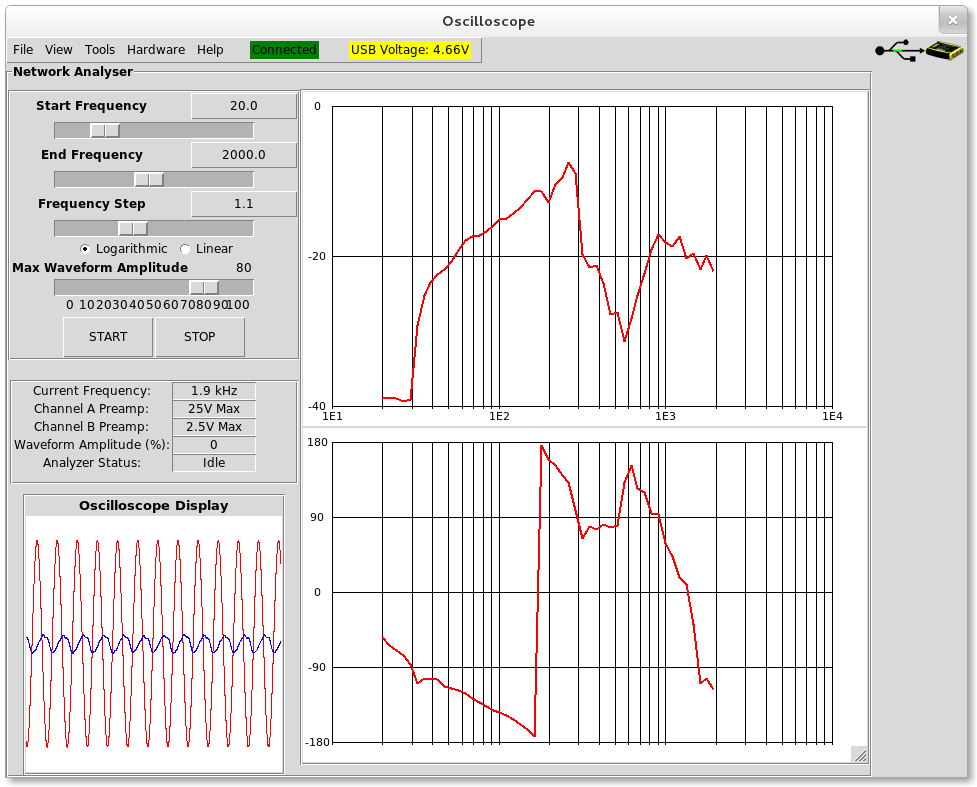
images/own_measurement/generator_shaker/piezo_fd_open_80p_8gain.png
