ojousima/thesis/images/own_measurement/generator_shaker/piezo_td_5k4_90hz_80p_8g.png

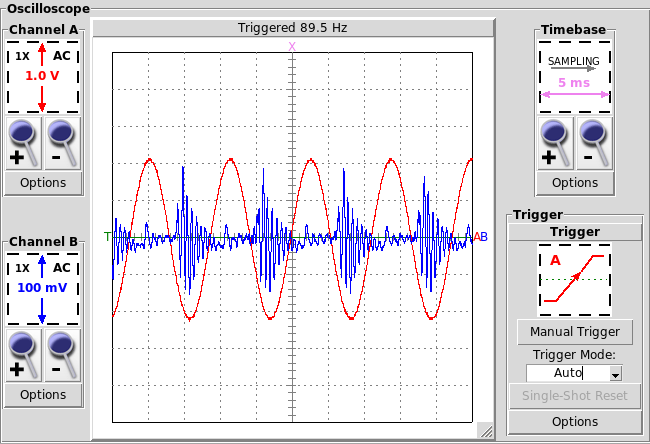
images/own_measurement/generator_shaker/piezo_td_5k4_90hz_80p_8g.png
