ojousima/thesis/images/own_measurement/generator_shaker/piezo_td_14k5_240Hz_80p_8g.png

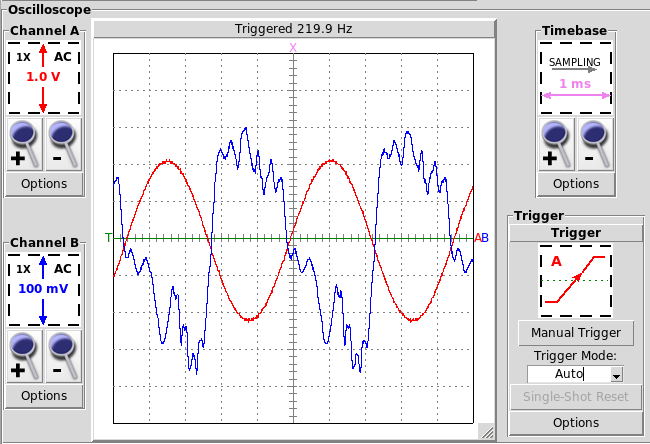
images/own_measurement/generator_shaker/piezo_td_14k5_240Hz_80p_8g.png
