ojousima/thesis/images/own_measurement/generator_shaker/piezo_td_28k_220hz_80p_8g.png

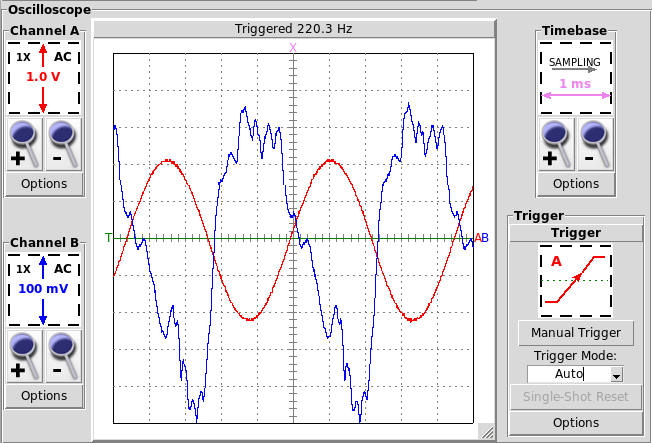
images/own_measurement/generator_shaker/piezo_td_28k_220hz_80p_8g.png
