ojousima/thesis/images/own_measurement/generator_shaker/piezo_td_100k_240hz_2.png

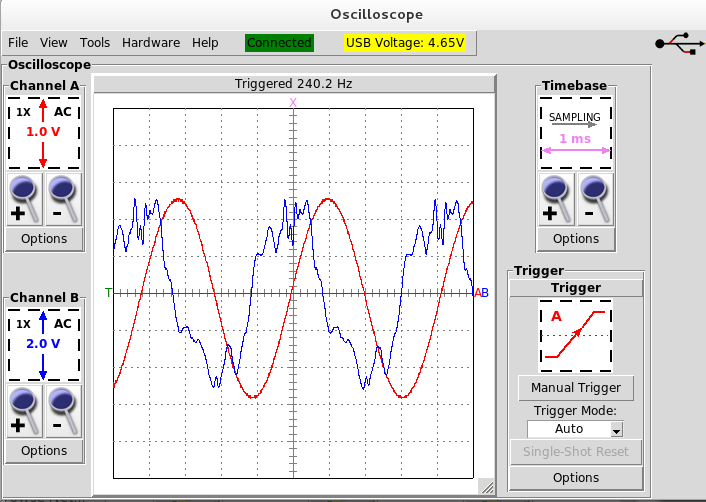
images/own_measurement/generator_shaker/piezo_td_100k_240hz_2.png
