ojousima/thesis/images/own_measurement/generator_shaker/piezo_td_100k_240hz_80p_8g.png

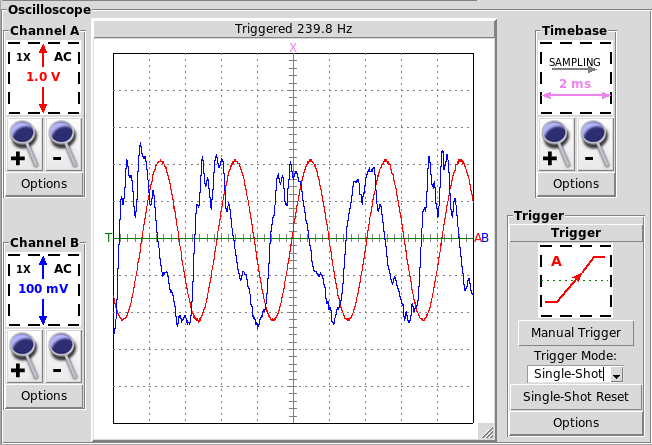
images/own_measurement/generator_shaker/piezo_td_100k_240hz_80p_8g.png
