ojousima/thesis/images/own_measurement/generator_shaker/piezo_td_200k_240Hz_80p_8g.png

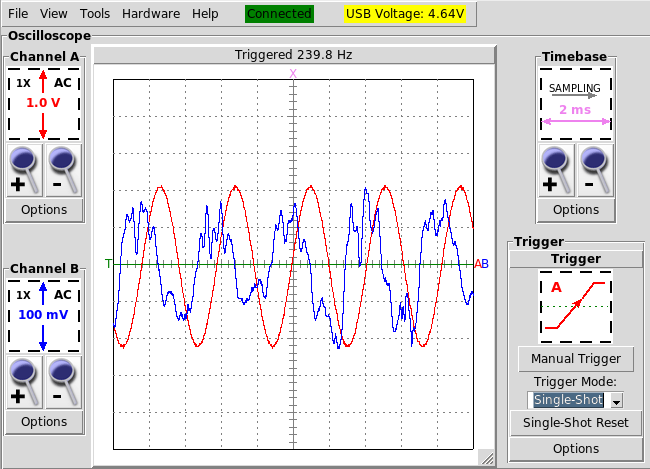
images/own_measurement/generator_shaker/piezo_td_200k_240Hz_80p_8g.png
