ojousima/thesis/images/own_measurement/generator_shaker/piezo_td_harvesting_vi_65Hz.png

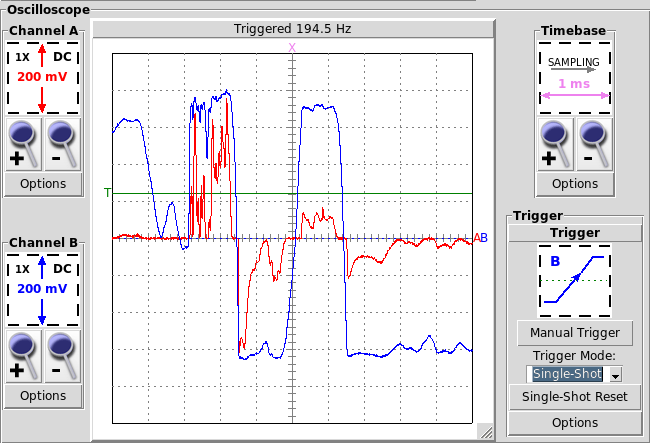
images/own_measurement/generator_shaker/piezo_td_harvesting_vi_65Hz.png
