ojousima/thesis/images/own_measurement/generator_shaker/piezo_td_open_230hz_2.png

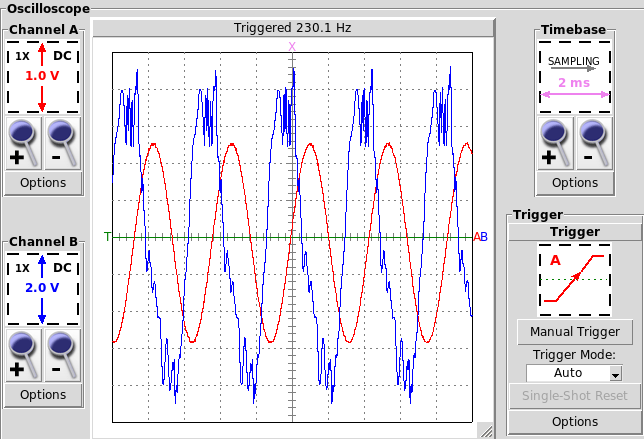
images/own_measurement/generator_shaker/piezo_td_open_230hz_2.png
