ojousima/thesis/images/own_measurement/generator_shaker/piezo_td_power_1k5hz_2_2.png

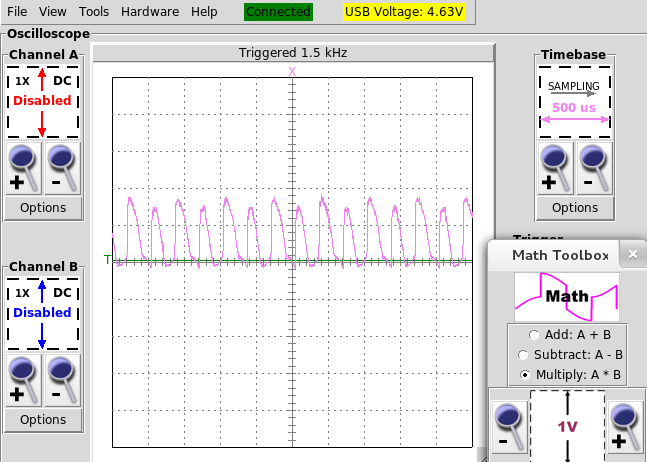
images/own_measurement/generator_shaker/piezo_td_power_1k5hz_2_2.png
