ojousima/thesis/images/own_measurement/generator_shaker/piezo_td_vi_2.png

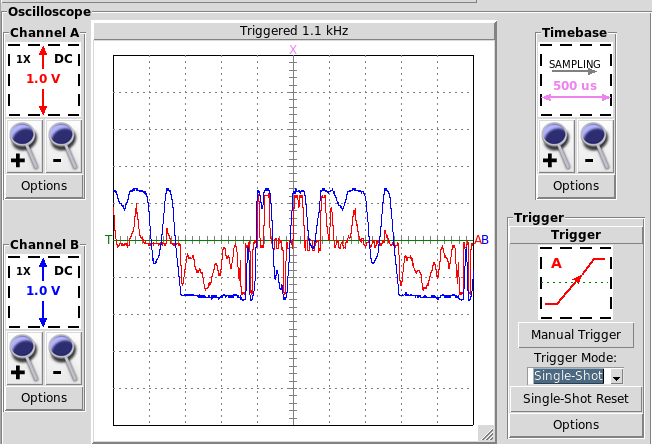
images/own_measurement/generator_shaker/piezo_td_vi_2.png
