ojousima/thesis/images/own_pic/piezo_test_setup/IMG_4918.JPG

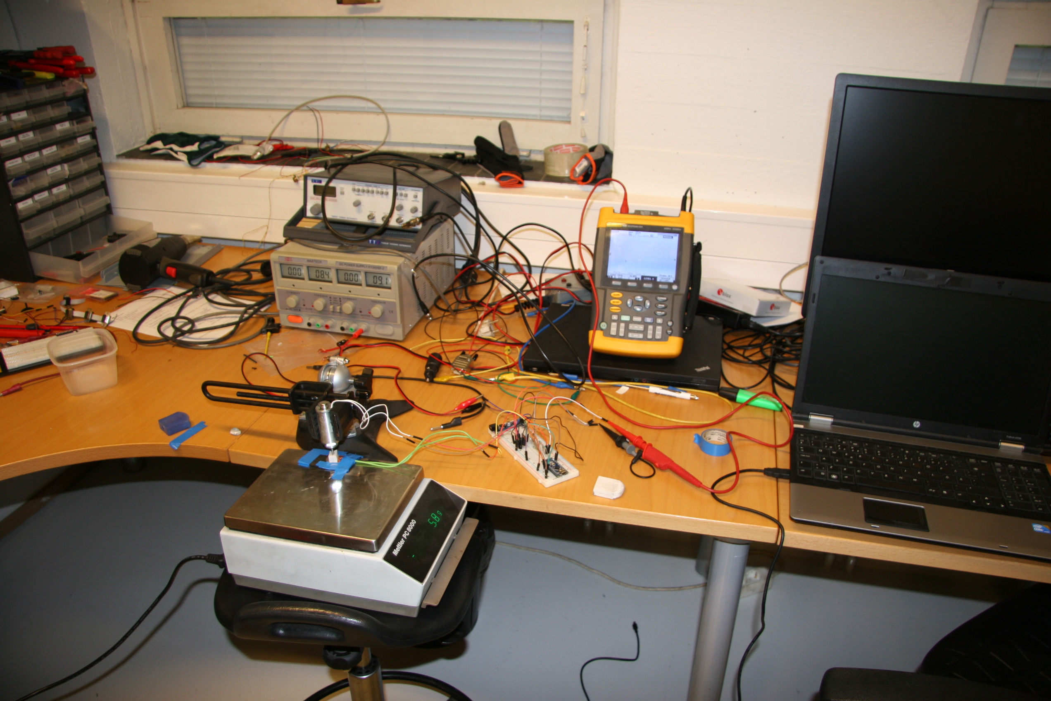
images/own_pic/piezo_test_setup/IMG_4918.JPG
