ojousima/thesis/images/own_pic/piezo_test_setup/IMG_4922.JPG

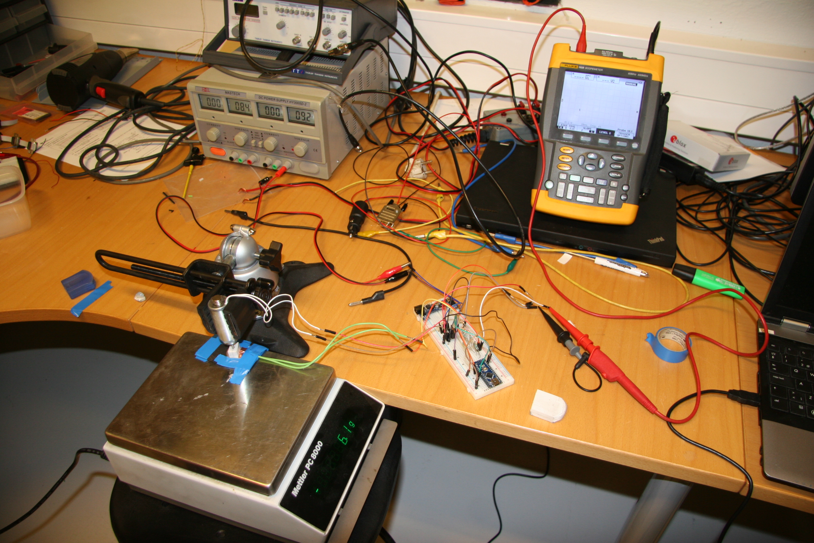
images/own_pic/piezo_test_setup/IMG_4922.JPG
