ojousima/thesis/images/own_pic/piezo_test_setup/IMG_4923.JPG

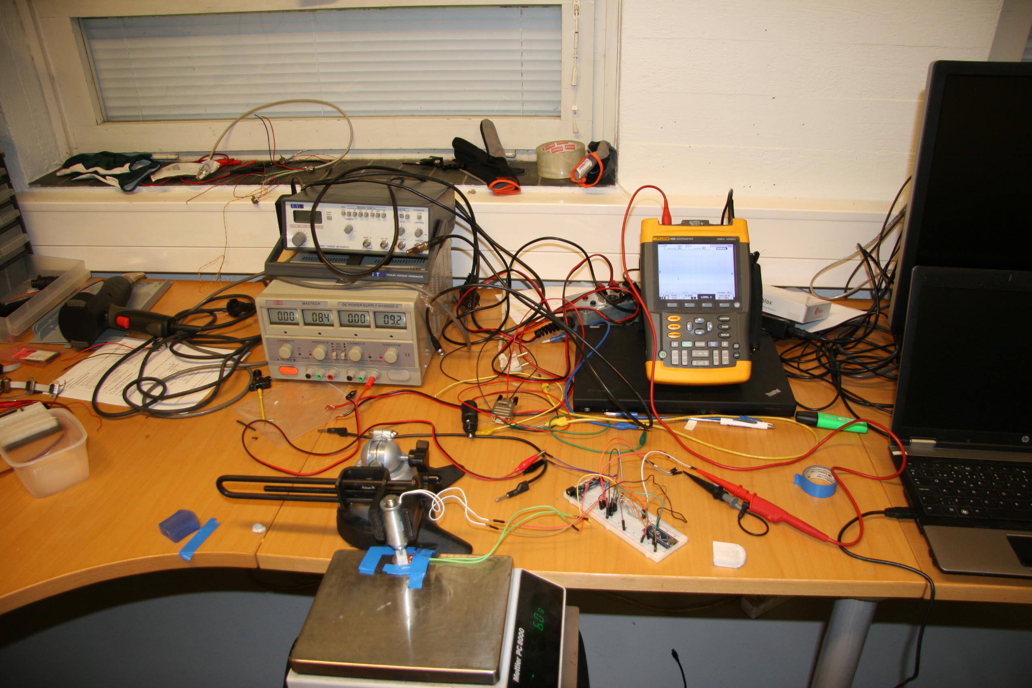
images/own_pic/piezo_test_setup/IMG_4923.JPG
