ojousima/thesis/images/own_pic/piezo_test_setup/IMG_4924.JPG

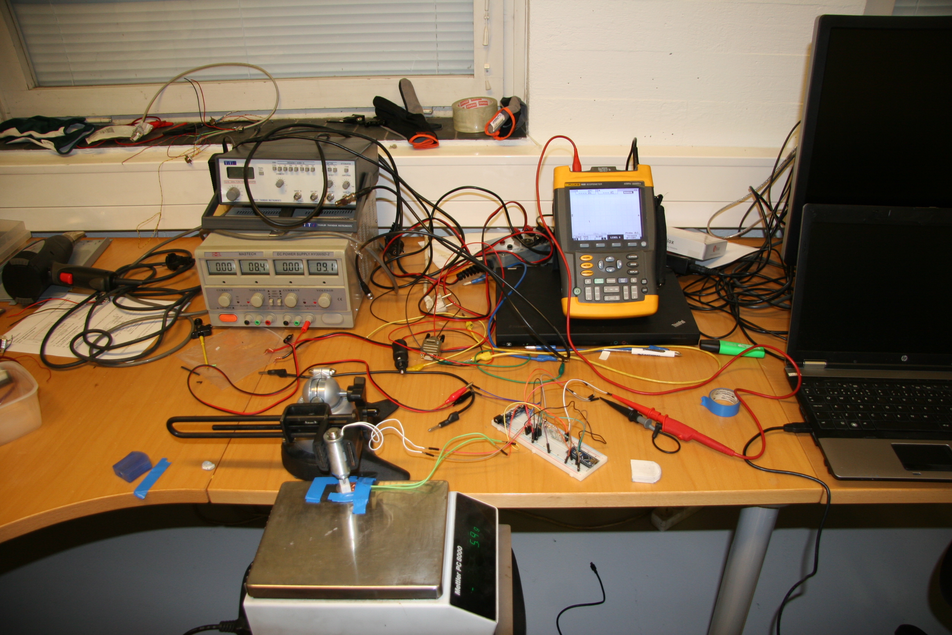
images/own_pic/piezo_test_setup/IMG_4924.JPG
