ojousima/thesis/measurements/emg/16hz.JPG

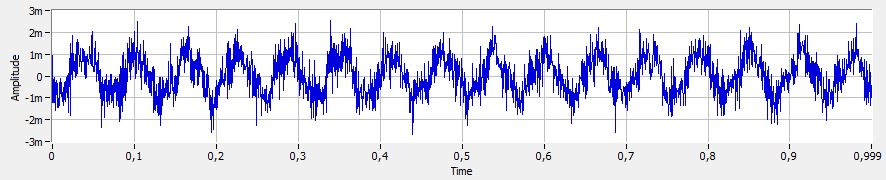
measurements/emg/16hz.JPG
