ojousima/thesis/hardware/MPPT/mppt.pdf

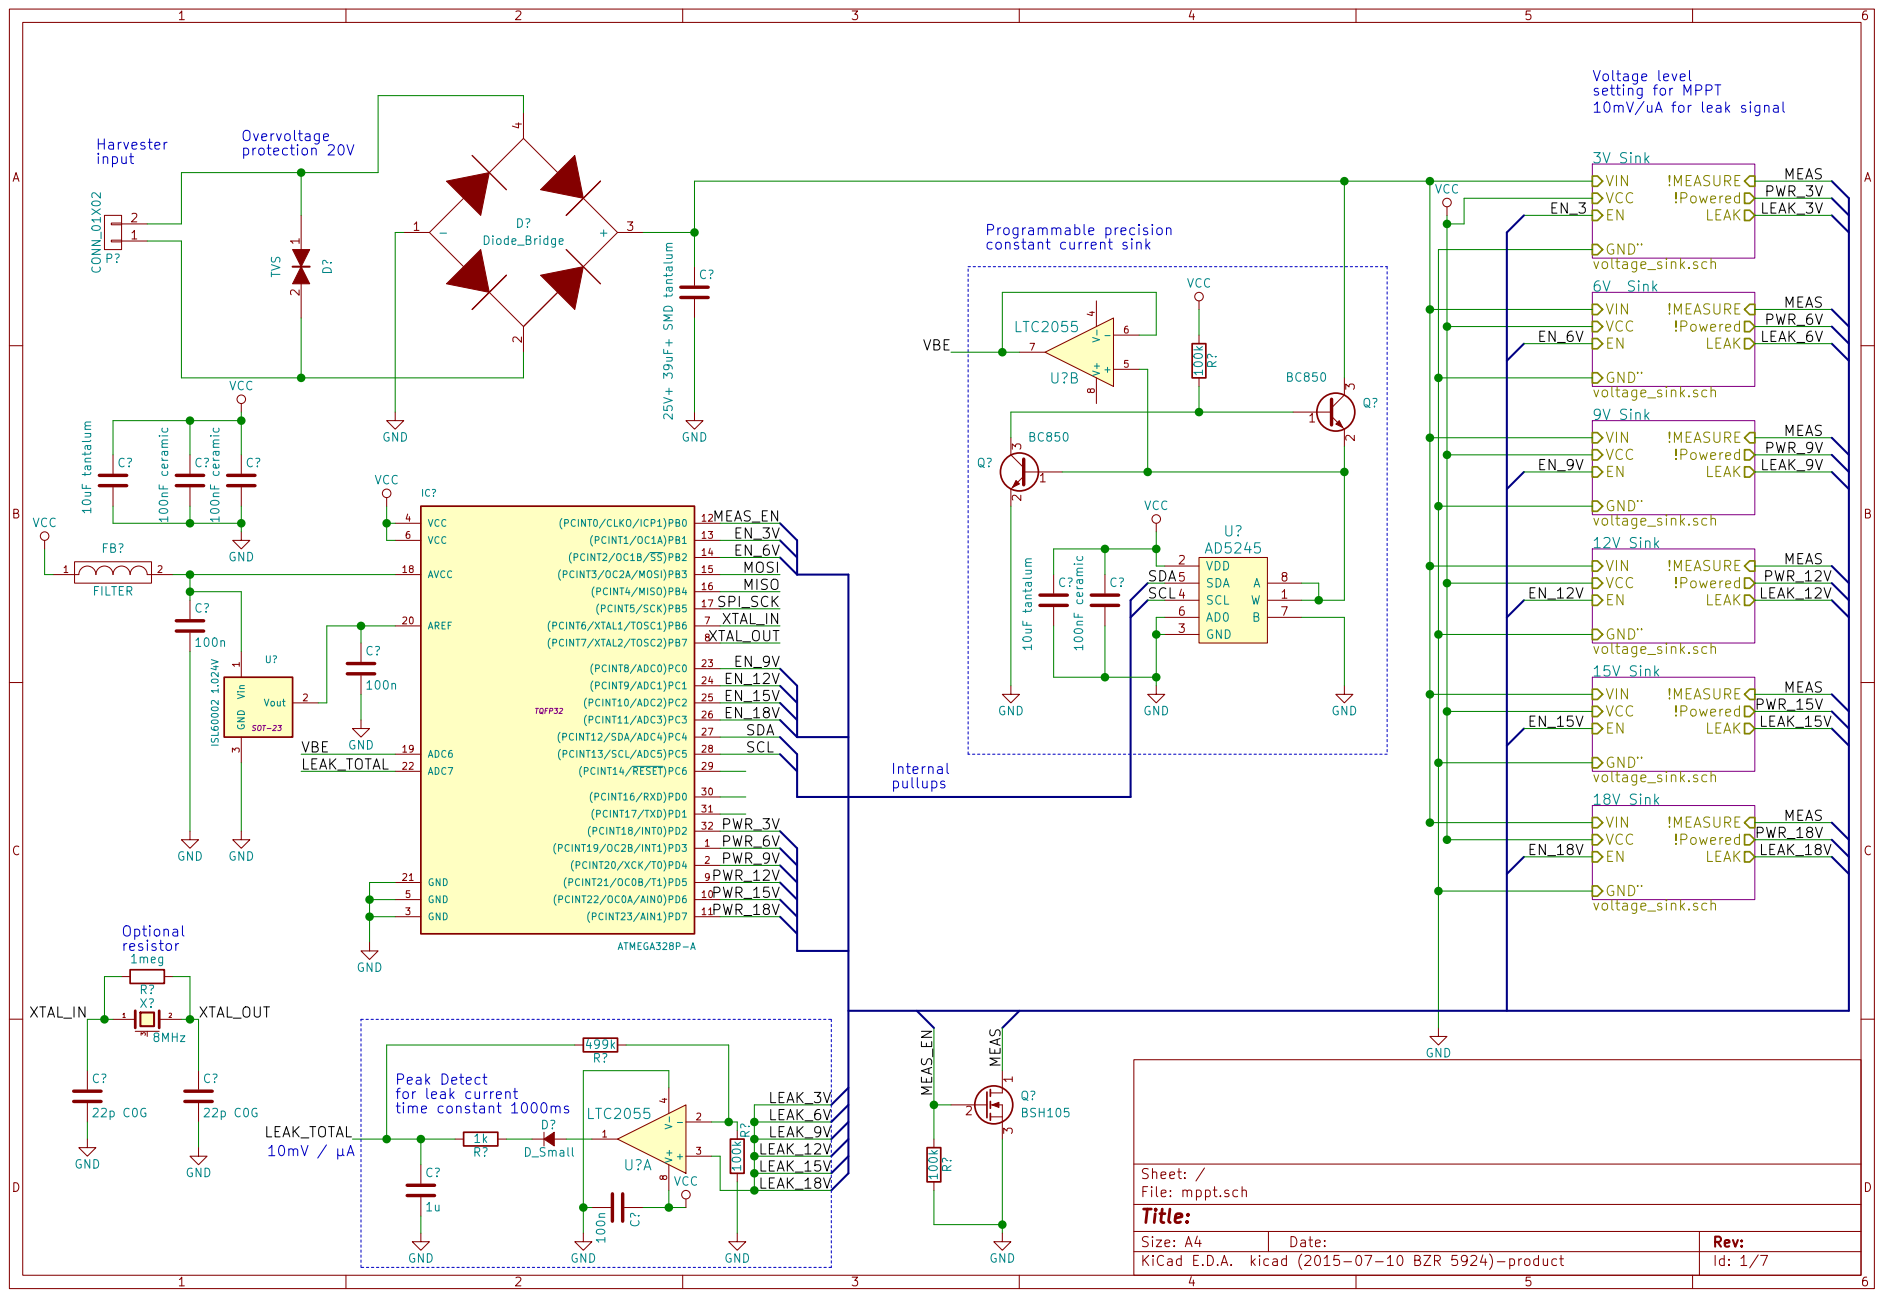
[picture p120: page 1]

10mV/uA for leak signal V- 4 V+

voltage_sink.sch VIN GND¨ EN

6V Sink

9V Sink

XTAL_IN
XTAL_OUT

LEAK_TOTAL | PWR_3V

18V Sink

LEAK_6V
LEAK_9V
LEAK_12V
LEAK_15V
LEAK_18V

File: mppt.sch Sheet: /
Id: 1/7 Title:

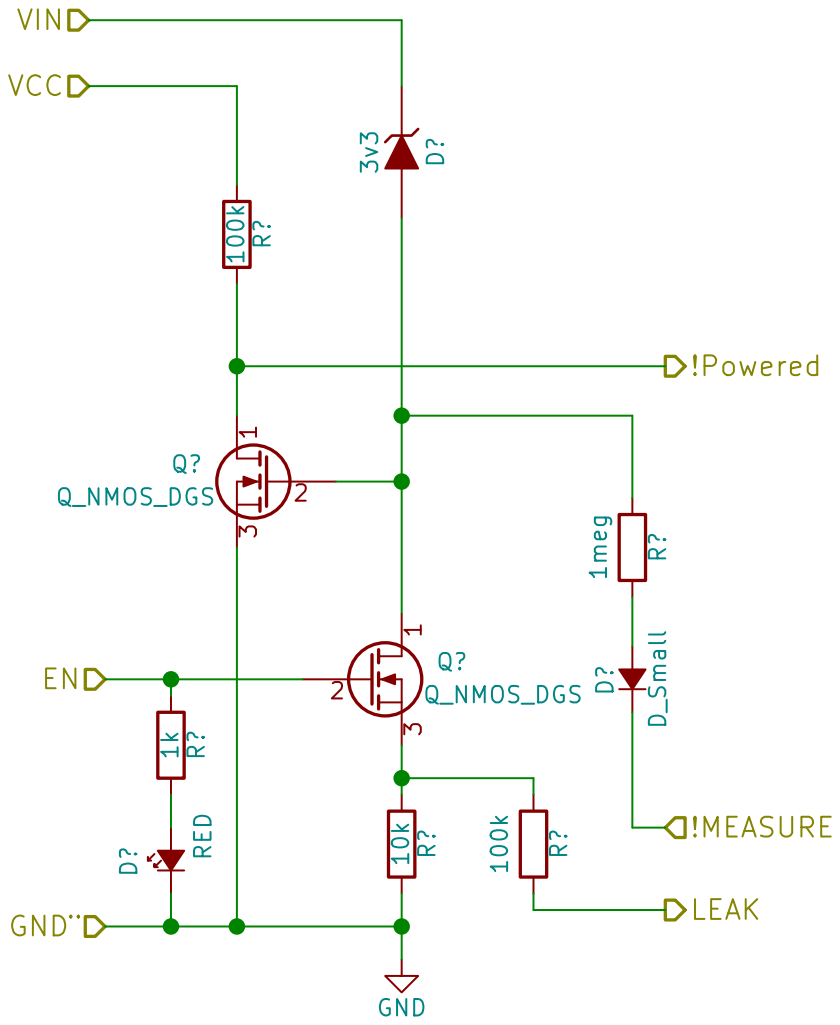
[picture p121: page 2]

File: voltage_sink.sch Sheet: /3V Sink/
Id: 2/7 Title:

File: voltage_sink.sch Sheet: /6V Sink/
Id: 3/7 Title:

File: voltage_sink.sch Sheet: /9V Sink/
Id: 4/7 Title:

File: voltage_sink.sch Sheet: /12V Sink/
Id: 5/7 Title:

File: voltage_sink.sch Sheet: /15V Sink/
Id: 6/7 Title:

File: voltage_sink.sch Sheet: /18V Sink/
Id: 7/7 Title:
