ojousima/thesis/images/own_dwg/circuit/radio.pdf

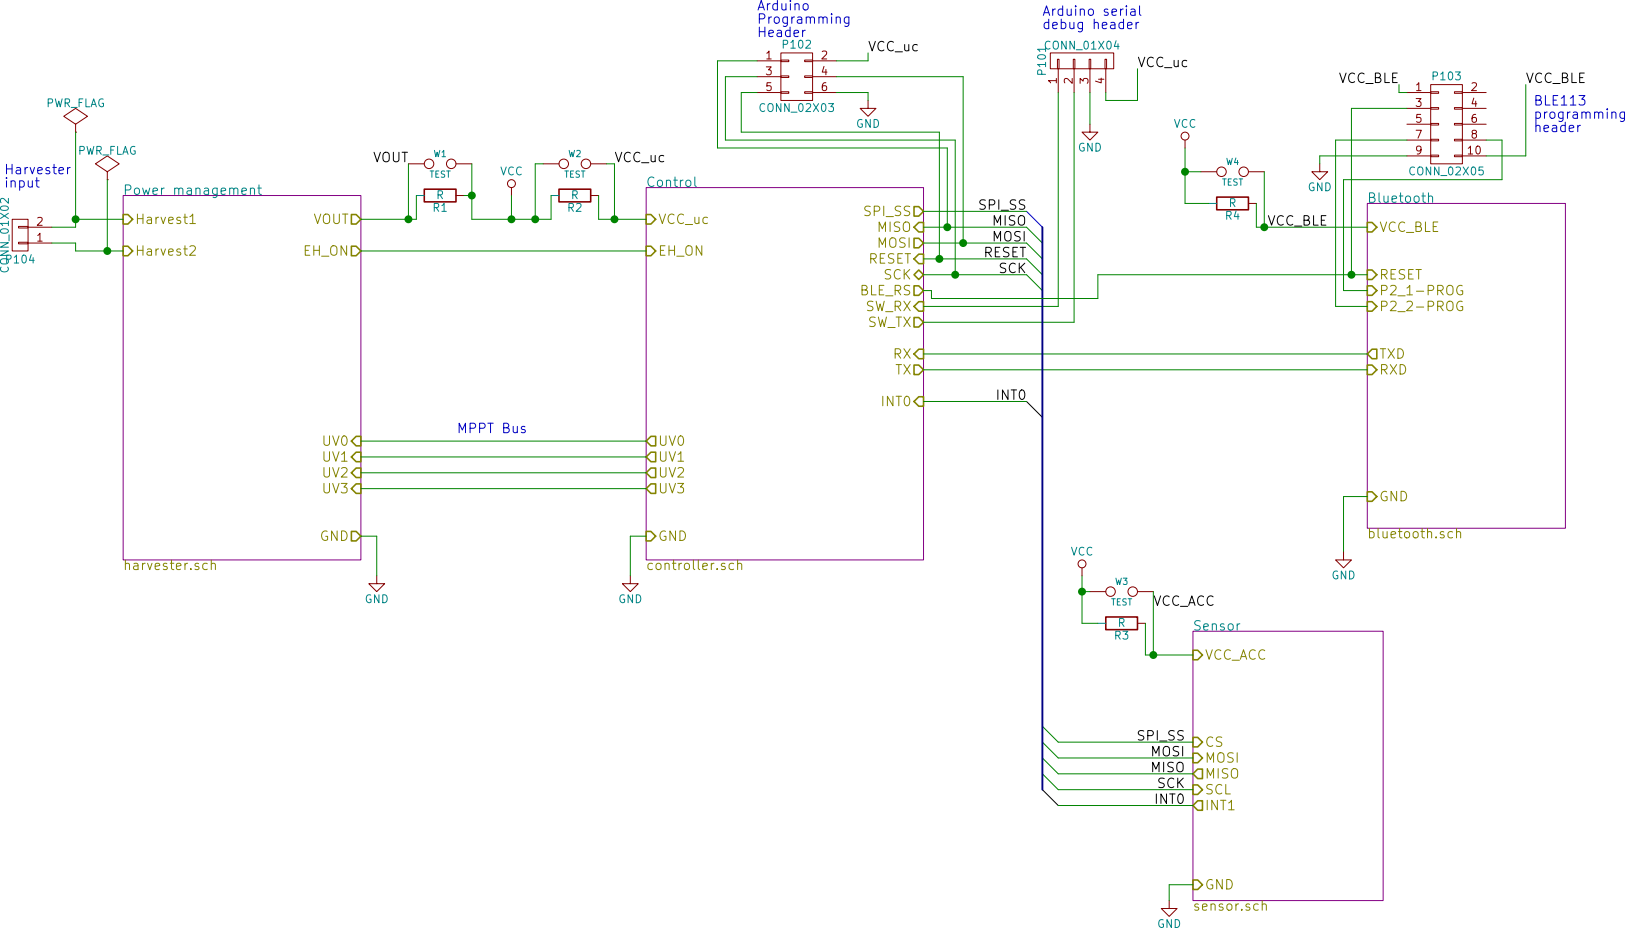
[picture p122: page 1]
