ojousima/thesis/images/own_dwg/circuit/bluetooth.pdf

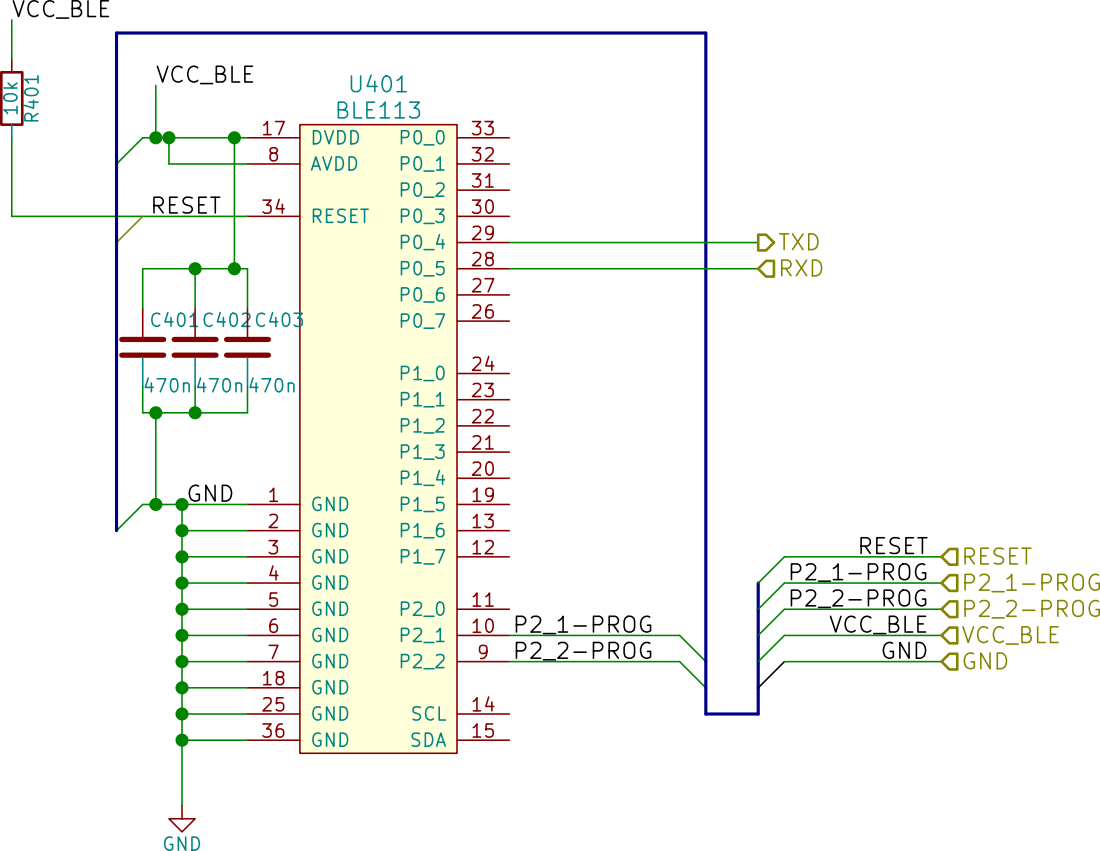
[picture p123: page 1]
