ojousima/thesis/images/own_dwg/circuit/control.pdf

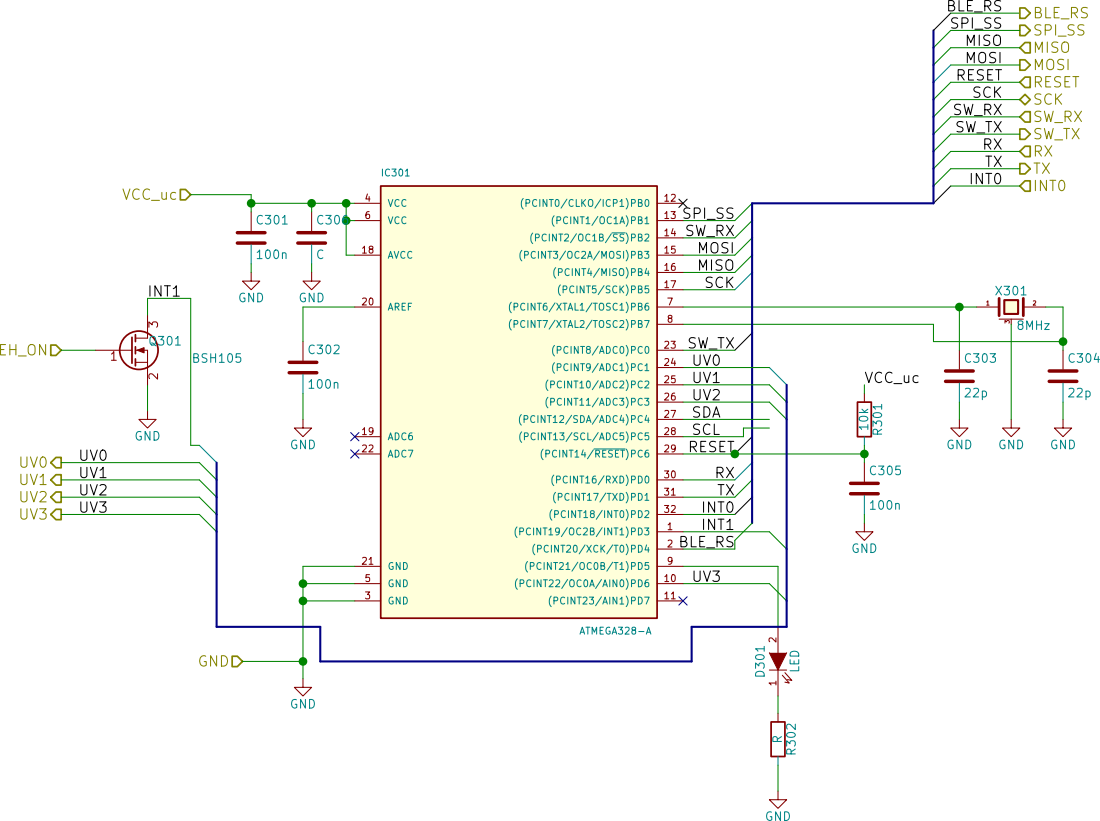
[picture p124: page 1]
