ojousima/thesis/images/own_dwg/circuit/harvester.pdf

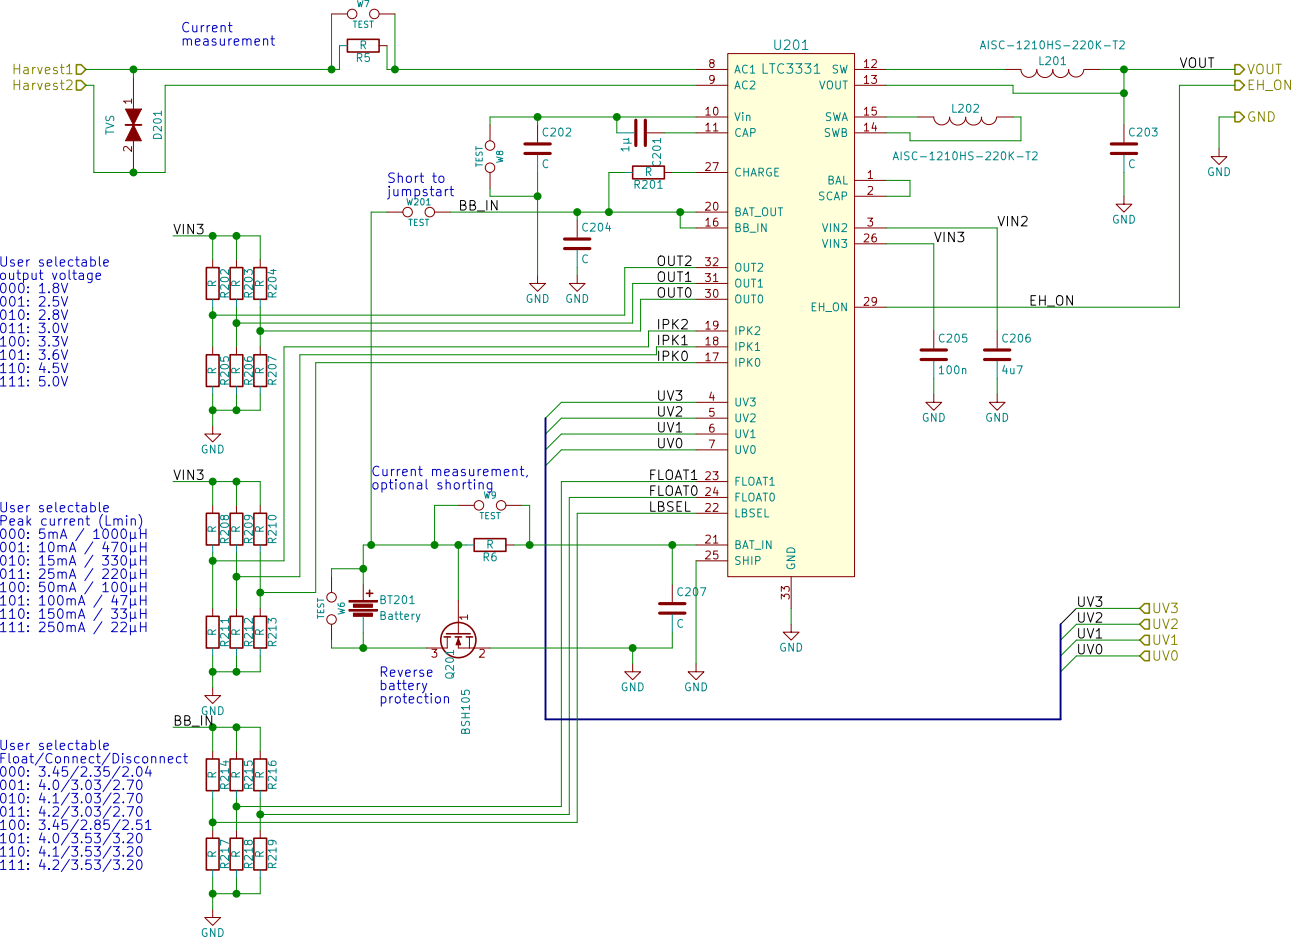
[picture p125: page 1]
