ojousima/thesis/images/own_dwg/circuit/sensor.pdf

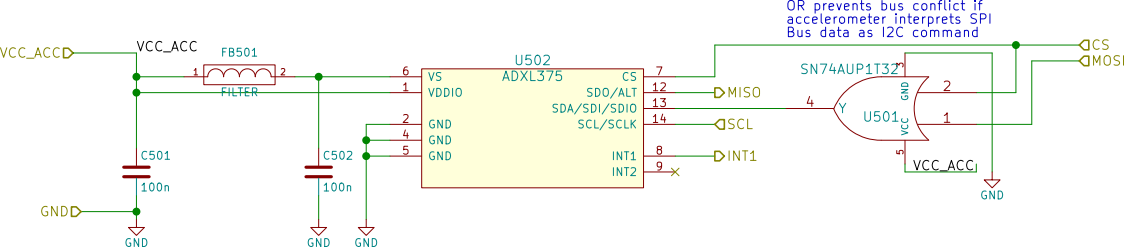
[picture p126: page 1]
