ojousima/thesis/simulation/LTSPICE/piezo_measure.asc

C1: cap; 39µ
M1: nmos; IRLML6346
M2: nmos; IRLML6346
R1: res; 50k
R2: res; 220k
R3: res; 100k
R4: res; 900k
R5: res; 1k
R6: res; 50k
R7: res; 10k
R8: res; 1k
U1: LTC2055
U2: LTC2055
V1: voltage; PULSE(0 20 0 0 0 40 100)
V2: voltage; 3.3
V3: voltage; PULSE(0 3.3 0.1 10u 10u 4m 100m 10000)
Named nets: 0, VCC
.tran 100 startup
