ojousima/thesis/simulation/LTSPICE/LTC3331.asc

C1: cap; 22µ
C2: cap; 1µ
C3: cap; 22µ
C4: cap; 4.7µ
C5: cap; 0µ1
C6: cap; 22µ
C7: cap; 1µ
C8: cap; 10
C9: cap; 39n
I1: current; SINE(0 202u 11 0.2 0 0 1k)
I2: current; PULSE(0 400u 4 10u 10u 100 101 10)
I3: current; PULSE(0 26m 5 10n 10n 10m 10 1)
L1: ind; 22µ; Rser=1
L2: ind; 22µ; Rser=1
R1: res; 120k
S1: sw; MYSW
U1: LTC3331
V1: voltage; 3.8; Rser=10
V3: voltage; 0
Named nets: 0, BB_IN, VIN3, BAT_IN
.tran 0 10 1 startup
.model MYSW SW(Ron=1 Roff=100Meg Vt=.5 Vh=-.4)
Energy harvesting source
Simulate battery 
connecting to circuit
Simulated 
load
Energy 
storage
