ojousima/thesis/simulation/LTSPICE/doubler_harvest.asc

C1: cap; 10µ
C2: cap; 10µ
D1: schottky; 1N5817
D2: schottky; 1N5817
R1: res; 1k
V1: voltage; SINE(0 2 65 0 0 0 100); Rser=34
Named nets: 0
.tran 100m
