ojousima/thesis/simulation/LTSPICE/doubler.asc

C1: cap; 47µ
C2: cap; 47µ
D1: schottky; 1N5819
D2: schottky; 1N5819
V1: voltage; SINE(0 1.5 81 0.1 0 0 10); Rser=34
Named nets: 0
.tran 0 1 0
