ojousima/thesis/simulation/LTSPICE/piezo_model.asc

C1: cap; 39n
I1: current; PULSE(0 280µ 10m 2m 0 5m 200m 10)
I2: current; PULSE(0 280u 100m 2m 0 5m 200m 10)
R1: res; {R}
Named nets: 0
.tran 0 1 0 startup
.step param R list 50k 150k 250k 350k 450k 550k
