ojousima/thesis/simulation/LTSPICE/active_rectification.asc

C1: cap; 1500µ
C2: cap; 1500µ
C5: cap; 10n
C6: cap; 1µ
C7: cap; 4.7µ
C8: cap; 10µ
L1: ind; 10µ
M1: nmos; IRLML6246
M2: nmos; IRLML6246
R3: res; 20k
R4: res; 1meg
R5: res; 430k
R6: res; 100
U1: LT1017
U2: LT1017
U3: LTC3105
V1: voltage; 1.5
V2: voltage; SINE(0 300m 60 0 0 0 10k); Rser=42
V3: voltage; 1.5
Named nets: 0
.tran 0 1 0 startup
