ojousima/thesis/simulation/LTSPICE/Peak_detect.asc

C1: cap; 1µ
D1: diode; 1N914
R1: R; 100k
R2: R; 100k
R3: R; 100k
R5: res; 1k
R6: res; 200k
R7: res; 100k
U1: LTC2055
V1: voltage; 0; Rser=1k
V2: voltage; 0; Rser=1k
V3: voltage; PULSE(0 1 0.1 0.10u 1m 1m 0.1 10); Rser=1k
V4: voltage; 3.3
Named nets: 0
.tran 1
