ojousima/thesis/hardware/BQ25504/bq25504.kicad_pcb

## KiCad design hardware/BQ25504/bq25504.kicad_pcb (2016-01-18)

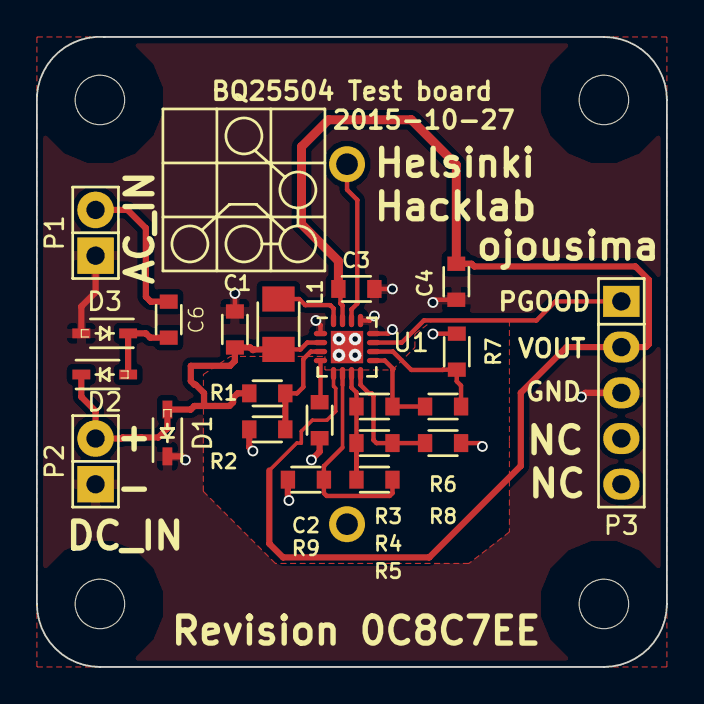
[picture p127: board bq25504.kicad_pcb from above]

Board: 2 copper layers, 35.0 x 35.0 mm, 27 parts (1 on the bottom side), 15 nets.

Parts:
C1, C2, C3, C4, C6: C; SMD0603_A
C5: EECRG0V155(V|H)N; EECRG0V155HN
D1: TVS; SOD-323-A
D2, D3: D_Schottky; SOD-323-A
L1: INDUCTOR_SMALL; SMD1206_A
NC1, NC2, NC3, NC4: Mounting_hole; m2.5_mechanical_npth_mount
P1, P2: CONN_01X02; Pin_Header_Straight_1x02
P3: CONN_01X03; Pin_Header_Straight_1x05
R1, R2, R3, R4, R5, R6, R7, R8, R9: R_Small; SMD0603_A
U1: BQ25504; QFN-16-1EP_3x3mm_Pitch0.5mm

Connections:
/HYST: R3.2, R6.1, U1.9
/PROG: R6.2, R7.1, U1.10
/VBAT_OK: P3.1, U1.11
/VBOV: R5.2, R9.1, U1.6
/VBUV: R4.2, R8.1, U1.8
/V_IN: C1.1, D1.2, D2.1, L1.1, P2.2, R1.1, U1.2
/V_OC_SAMP: R1.2, R2.1, U1.3
/V_RDIV: R3.1, R4.1, R5.1, U1.7
/V_REF: C2.2, U1.4
/V_SYS: C3.1, C4.1, P3.2, U1.5, U1.15
GND: C1.2, C2.1, C3.2, C4.2, C5.2, D1.1, D3.2, P1.1, P2.1, P3.3, R2.2, R7.2, R8.2, R9.2, U1.1, U1.12, U1.13, U1.17
unnamed: C5.1, U1.14
unnamed: C6.1, D2.2, D3.1
unnamed: C6.2, P1.2
unnamed: L1.2, U1.16
