ojousima/thesis/hardware/radio/radio.kicad_pcb

## KiCad design hardware/radio/radio.kicad_pcb (2015-09-13)

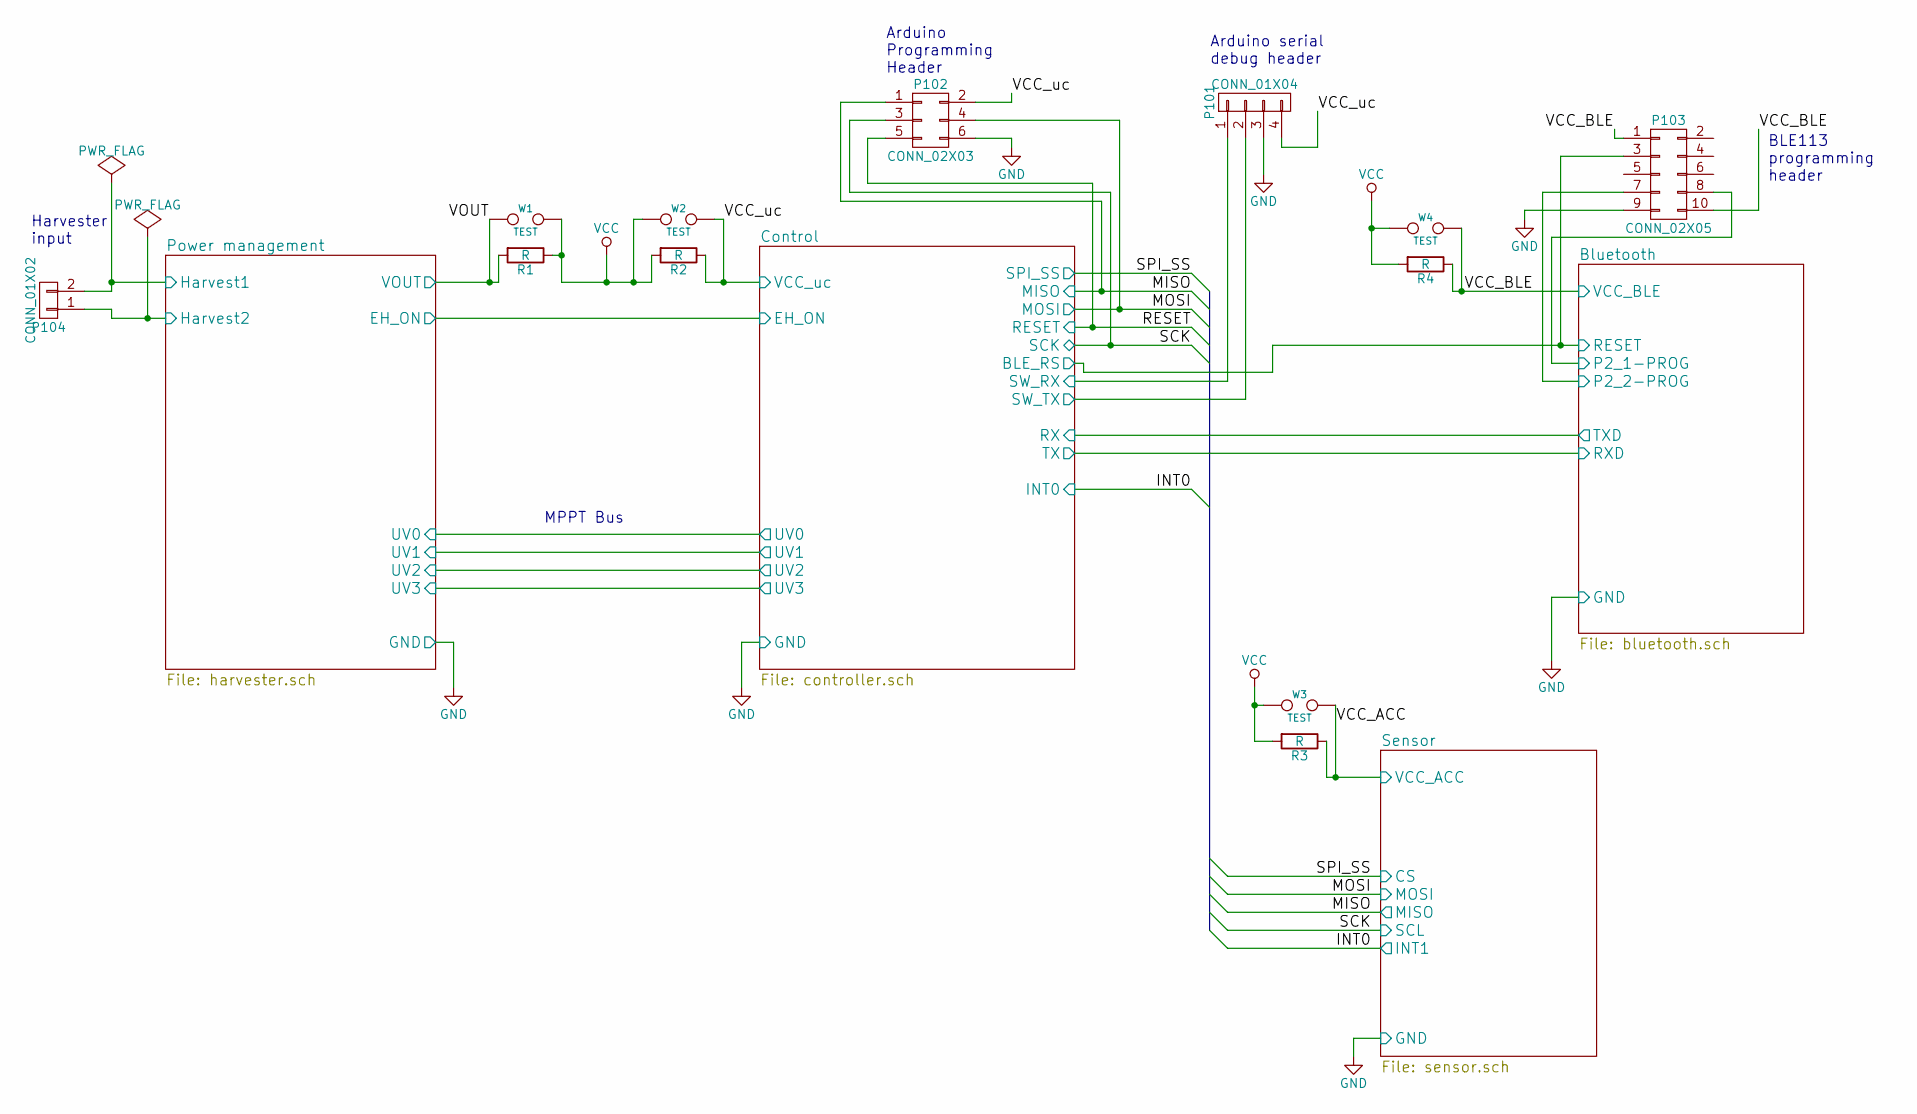
[picture p128: schematic radio.sch, Energy harvesting sensor board with BLE radio]

Parts:
P101: CONN_01X04; Pin_Header_Straight_1x04
P102: CONN_02X03; Pin_Header_Straight_2x03
P103: CONN_02X05; Pin_Header_Straight_2x05_Pitch1.27mm
P104: CONN_01X02; Pin_Header_Straight_1x02
R1, R2, R3, R4: R; R_0603
W1, W2, W3, W4: TEST; Test_pair_TH_small

Connections:
/Bluetooth/P2_1-PROG: P103.8; also elsewhere on the board
/Bluetooth/P2_2-PROG: P103.7; also elsewhere on the board
/Bluetooth/VCC_BLE: P103.1, P103.10, R4.1, W4.2; also elsewhere on the board
/Control/BLE_RS: P103.3; also elsewhere on the board
/Control/MISO: P102.1; also elsewhere on the board
/Control/MOSI: P102.4; also elsewhere on the board
/Control/RESET: P102.5; also elsewhere on the board
/Control/SCK: P102.3; also elsewhere on the board
/Control/SW_RX: P101.1; also elsewhere on the board
/Control/SW_TX: P101.2; also elsewhere on the board
/Control/VCC_uc: P101.4, P102.2, R2.1, W2.2; also elsewhere on the board
/Power management/Harvest1: P104.2; also elsewhere on the board
/Power management/Harvest2: P104.1; also elsewhere on the board
/Power management/VOUT: R1.2, W1.1; also elsewhere on the board
/Sensor/VCC_ACC: R3.1, W3.2; also elsewhere on the board
GND: P101.3, P102.6, P103.9; also elsewhere on the board
VCC: R1.1, R2.2, R3.2, R4.2, W1.2, W2.1, W3.1, W4.1

Notes on the sheet:
Harvester input
MPPT Bus
BLE113 programming header
Arduino Programming Header
Arduino serial debug header

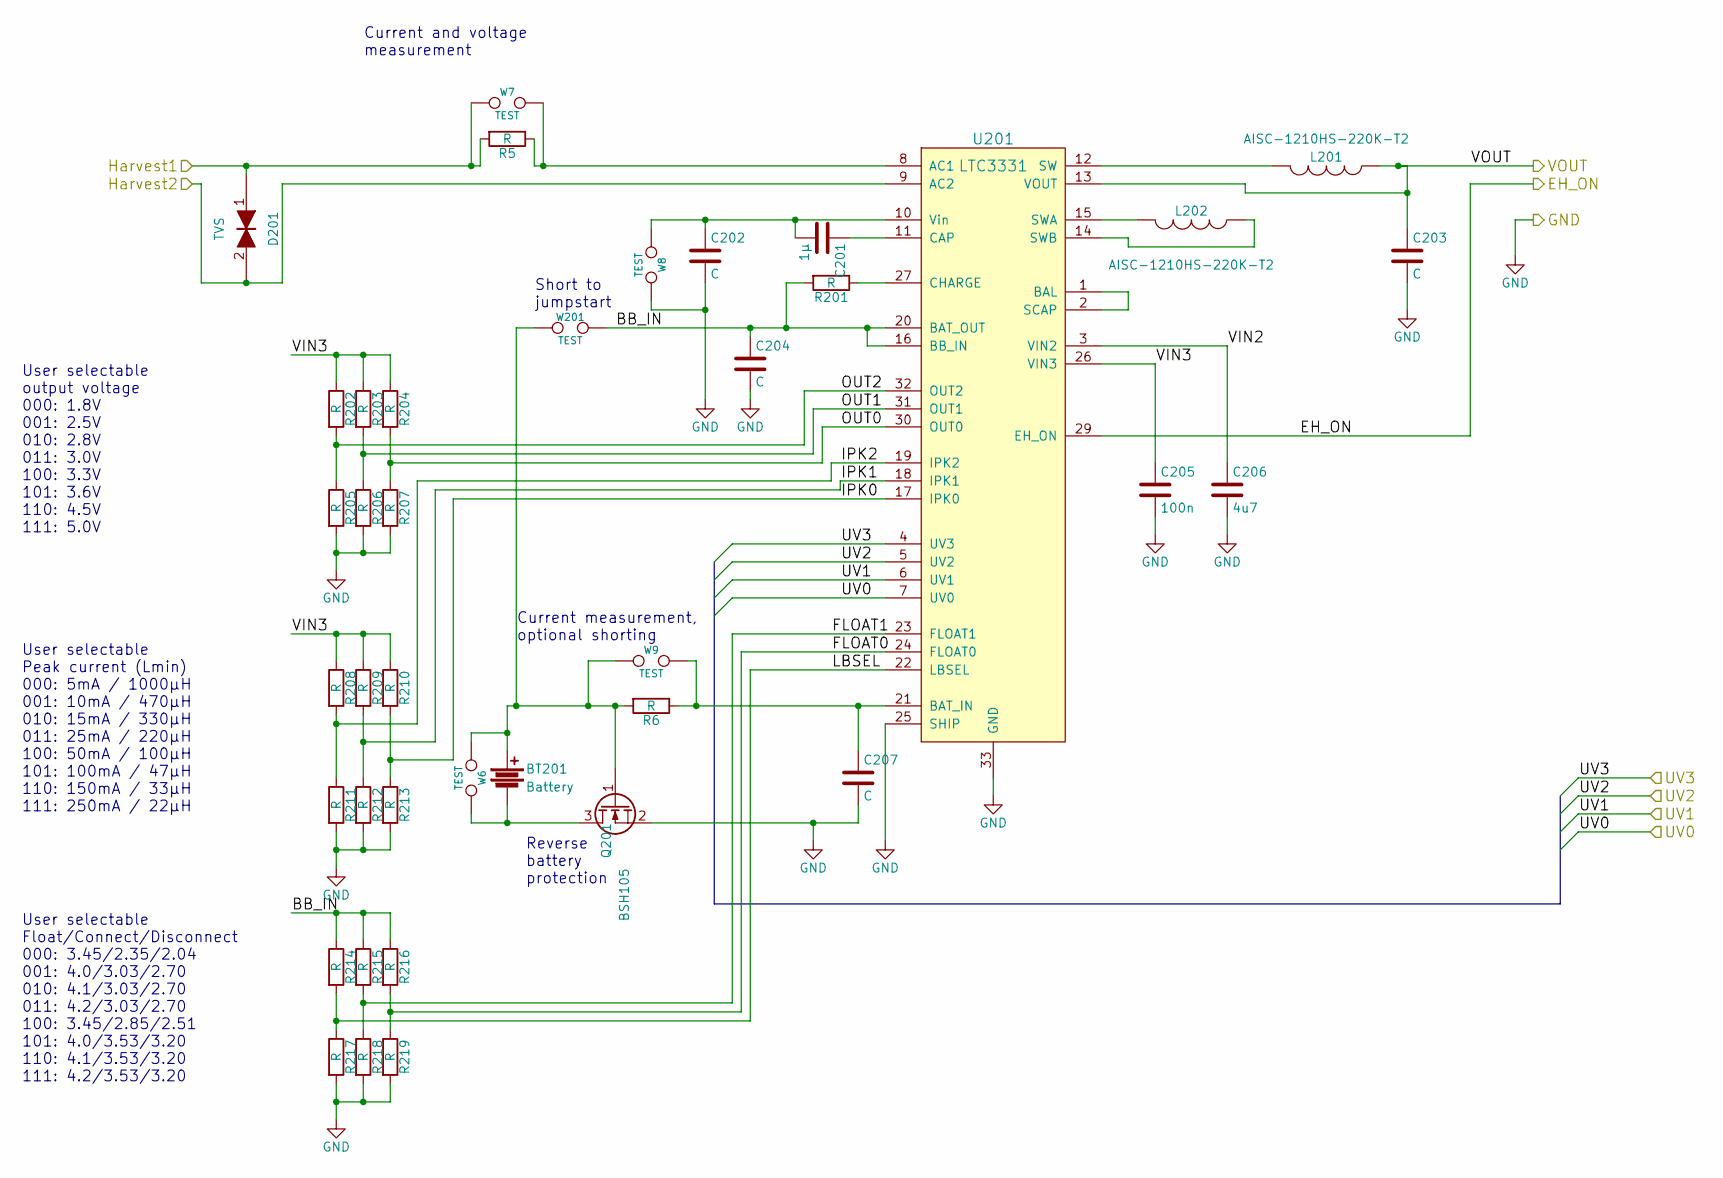
[picture p129: schematic harvester.sch, Energy harvesting sensor board with BLE radio]

Parts:
BT201: Battery; CR2032-holder-S8421R
C201: 1µ; C_0603
C202, C203, C204, C207: C; C_0603
C205: 100n; C_0603
C206: 4u7; C_0603
D201: TVS; SOD-323
L201, L202: AISC-1210HS-220K-T2; R_1210
Q201: BSH105
R5, R6, R201, R202, R203, R204, R205, R206, R207, R208, R209, R210, R211, R212, R213, R214, R215, R216, R217, R218, R219: R; R_0603
U201: LTC3331; QFN-32-1EP_5x5mm_Pitch0.5mm
W6, W8: TEST; Test_pair_TH_tiny
W7, W9, W201: TEST; Test_pair_TH_small

Connections:
/Control/EH_ON: U201.29 (EH_ON); also elsewhere on the board
/Control/UV0: U201.7 (UV0); also elsewhere on the board
/Control/UV1: U201.6 (UV1); also elsewhere on the board
/Control/UV2: U201.5 (UV2); also elsewhere on the board
/Control/UV3: U201.4 (UV3); also elsewhere on the board
/Power management/BB_IN: C204.1, R201.2, R214.1, R215.1, R216.1, U201.16 (BB_IN), U201.20 (BAT_OUT), W201.2
/Power management/FLOAT0: R216.2, R219.1, U201.24 (FLOAT0)
/Power management/FLOAT1: R215.2, R218.1, U201.23 (FLOAT1)
/Power management/Harvest1: D201.1, R5.2, W7.1; also elsewhere on the board
/Power management/Harvest2: D201.2, U201.9 (AC2); also elsewhere on the board
/Power management/IPK0: R210.2, R213.1, U201.17 (IPK0)
/Power management/IPK1: R209.2, R212.1, U201.18 (IPK1)
/Power management/IPK2: R208.2, R211.1, U201.19 (IPK2)
/Power management/LBSEL: R214.2, R217.1, U201.22 (LBSEL)
/Power management/OUT0: R204.2, R207.1, U201.30 (OUT0)
/Power management/OUT1: R203.2, R206.1, U201.31 (OUT1)
/Power management/OUT2: R202.2, R205.1, U201.32 (OUT2)
/Power management/VIN2: C206.1, U201.3 (VIN2)
/Power management/VIN3: C205.1, R202.1, R203.1, R204.1, R208.1, R209.1, R210.1, U201.26 (VIN3)
/Power management/VOUT: C203.1, L201.1, U201.13 (VOUT); also elsewhere on the board
GND: C202.2, C203.2, C204.2, C205.2, C206.2, C207.2, Q201.2 (S), R205.2, R206.2, R207.2, R211.2, R212.2, R213.2, R217.2, R218.2, R219.2, U201.25 (SHIP), U201.33 (GND), W8.2; also elsewhere on the board
unnamed: BT201.1, Q201.1 (G), R6.2, W6.1, W9.1, W201.1
unnamed: BT201.2, Q201.3 (D), W6.2
unnamed: C201.1, U201.11 (CAP)
unnamed: C201.2, C202.1, U201.10 (Vin), W8.1
unnamed: C207.1, R6.1, U201.21 (BAT_IN), W9.2
unnamed: L201.2, U201.12 (SW)
unnamed: L202.1, U201.14 (SWB)
unnamed: L202.2, U201.15 (SWA)
unnamed: R5.1, U201.8 (AC1), W7.2
unnamed: R201.1, U201.27 (CHARGE)
unnamed: U201.1 (BAL), U201.2 (SCAP)

Notes on the sheet:
User selectable output voltage 000: 1.8V 001: 2.5V 010: 2.8V 011: 3.0V 100: 3.3V 101: 3.6V 110: 4.5V 111: 5.0V
User selectable Float/Connect/Disconnect 000: 3.45/2.35/2.04 001: 4.0/3.03/2.70 010: 4.1/3.03/2.70 011: 4.2/3.03/2.70 100: 3.45/2.85/2.51 101: 4.0/3.53/3.20 110: 4.1/3.53/3.20 111: 4.2/3.53/3.20
User selectable Peak current (Lmin) 000: 5mA / 1000µH 001: 10mA / 470µH 010: 15mA / 330µH 011: 25mA / 220µH 100: 50mA / 100µH 101: 100mA / 47µH 110: 150mA / 33µH 111: 250mA / 22µH
Reverse battery protection
Current measurement, optional shorting
Current and voltage measurement
Short to jumpstart

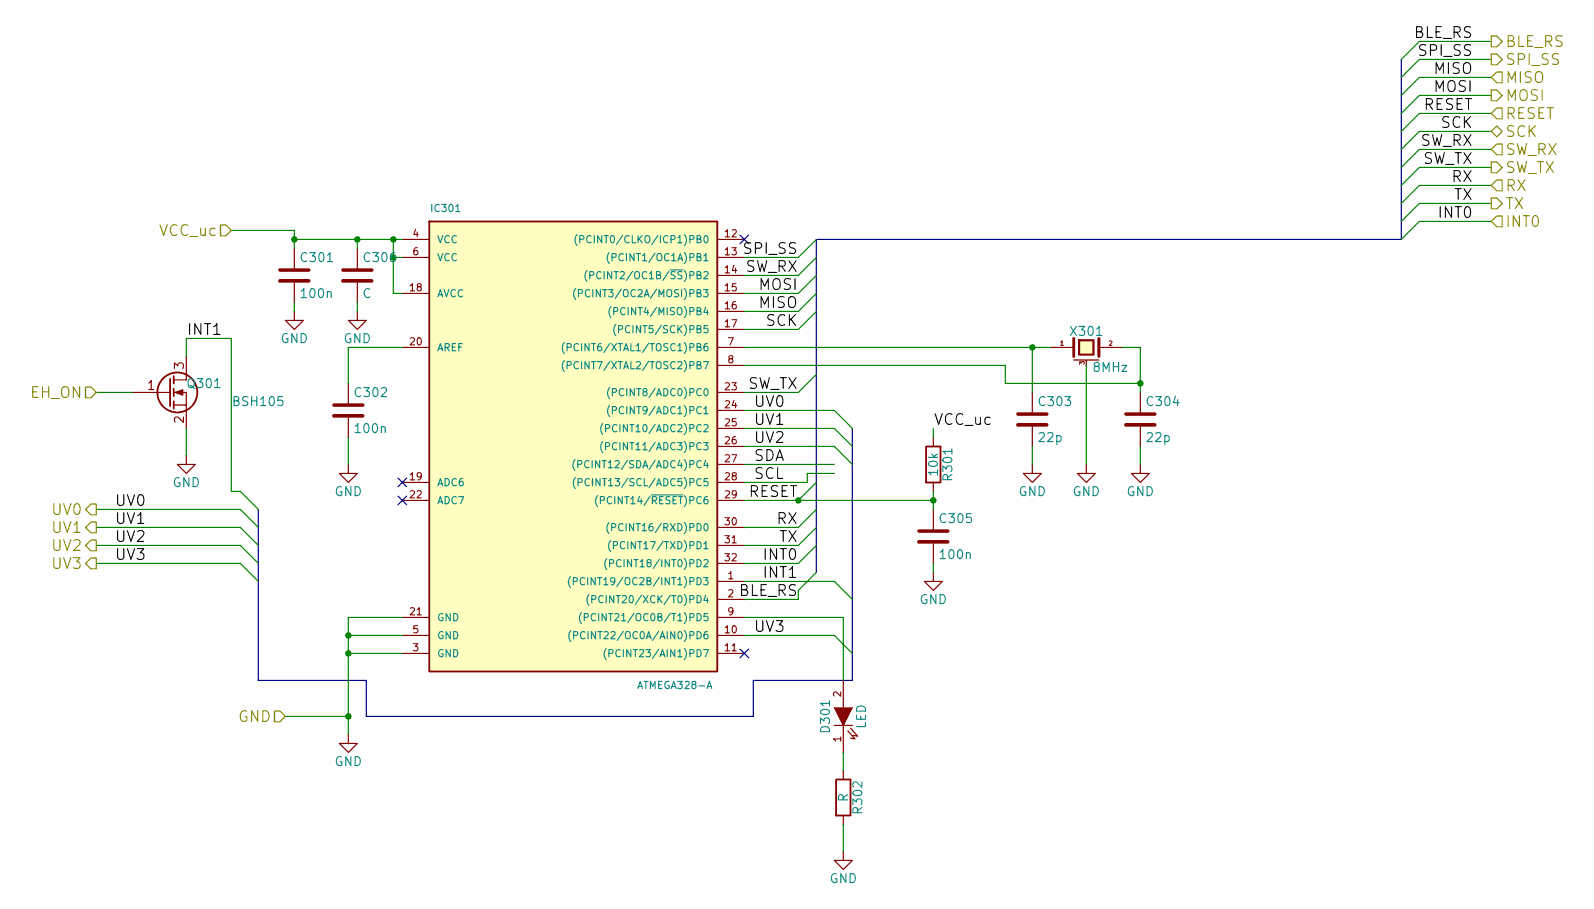
[picture p130: schematic controller.sch, Energy harvesting sensor board with BLE radio]

Parts:
C301, C302, C305: 100n; C_0603
C303, C304: 22p; C_0603
C306: C; C_0603
D301: LED; LED-0603
IC301: ATMEGA328-A; TQFP-32_7x7mm_Pitch0.8mm
Q301: BSH105
R301: 10k; R_0603
R302: R; R_0603
X301: 8MHz; crystal_FA238-TSX3225

Connections:
/Bluetooth/RXD: IC301.31 ((PCINT17/TXD)PD1); also elsewhere on the board
/Control/BLE_RS: IC301.2 ((PCINT20/XCK/T0)PD4); also elsewhere on the board
/Control/EH_ON: Q301.1 (G); also elsewhere on the board
/Control/INT0: IC301.32 ((PCINT18/INT0)PD2); also elsewhere on the board
/Control/INT1: IC301.1 ((PCINT19/OC2B/INT1)PD3), Q301.3 (D)
/Control/MISO: IC301.16 ((PCINT4/MISO)PB4); also elsewhere on the board
/Control/MOSI: IC301.15 ((PCINT3/OC2A/MOSI)PB3); also elsewhere on the board
/Control/RESET: C305.1, IC301.29 ((PCINT14/~RESET~)PC6), R301.2; also elsewhere on the board
/Control/RX: IC301.30 ((PCINT16/RXD)PD0); also elsewhere on the board
/Control/SCK: IC301.17 ((PCINT5/SCK)PB5); also elsewhere on the board
/Control/SCL: IC301.28 ((PCINT13/SCL/ADC5)PC5)
/Control/SDA: IC301.27 ((PCINT12/SDA/ADC4)PC4)
/Control/SW_RX: IC301.14 ((PCINT2/OC1B/~SS~)PB2); also elsewhere on the board
/Control/SW_TX: IC301.23 ((PCINT8/ADC0)PC0); also elsewhere on the board
/Control/UV0: IC301.24 ((PCINT9/ADC1)PC1); also elsewhere on the board
/Control/UV1: IC301.25 ((PCINT10/ADC2)PC2); also elsewhere on the board
/Control/UV2: IC301.26 ((PCINT11/ADC3)PC3); also elsewhere on the board
/Control/UV3: IC301.10 ((PCINT22/OC0A/AIN0)PD6); also elsewhere on the board
/Control/VCC_uc: C301.1, C306.1, IC301.4 (VCC), IC301.6 (VCC), IC301.18 (AVCC), R301.1; also elsewhere on the board
/Sensor/CS: IC301.13 ((PCINT1/OC1A)PB1); also elsewhere on the board
GND: C301.2, C302.2, C303.2, C304.2, C305.2, C306.2, IC301.3 (GND), IC301.5 (GND), IC301.21 (GND), Q301.2 (S), R302.2, X301.3 (case); also elsewhere on the board
unnamed: C302.1, IC301.20 (AREF)
unnamed: C303.1, IC301.7 ((PCINT6/XTAL1/TOSC1)PB6), X301.1
unnamed: C304.1, IC301.8 ((PCINT7/XTAL2/TOSC2)PB7), X301.2
unnamed: D301.1 (K), R302.1
unnamed: D301.2 (A), IC301.9 ((PCINT21/OC0B/T1)PD5)

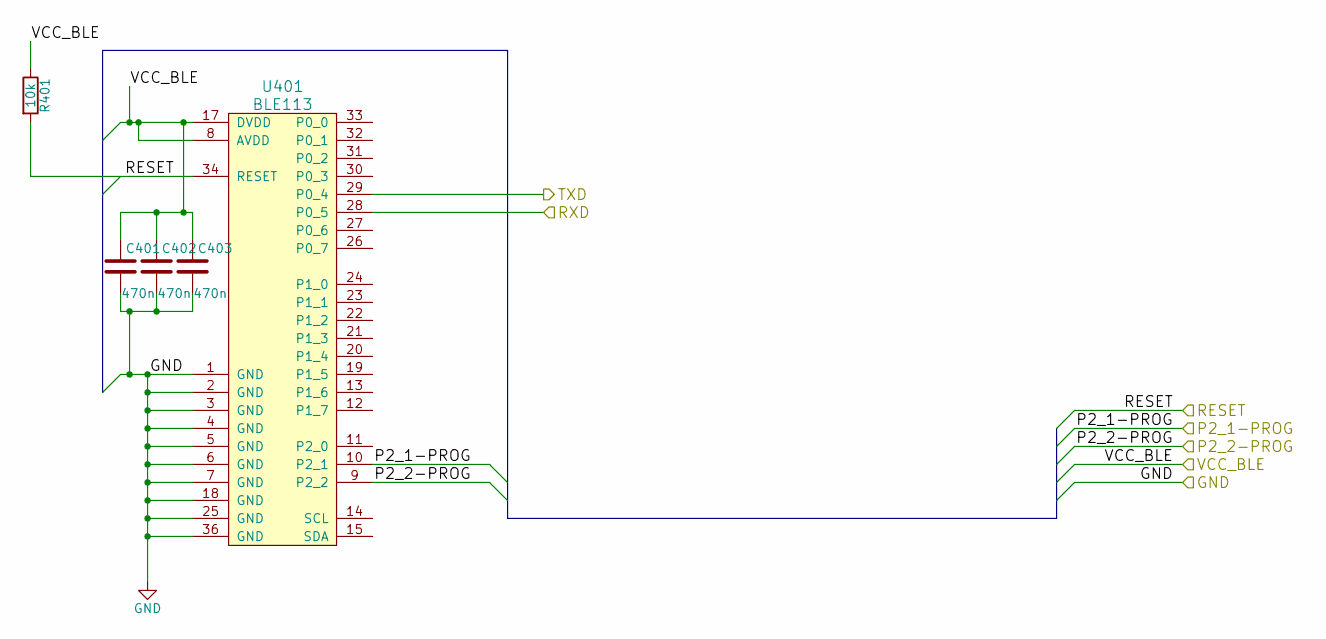
[picture p131: schematic bluetooth.sch, Energy harvesting sensor board with BLE radio]

Parts:
C401, C402, C403: 470n; C_0603
R401: 10k; R_0603
U401: BLE113

Connections:
/Bluetooth/P2_1-PROG: U401.10 (P2_1); also elsewhere on the board
/Bluetooth/P2_2-PROG: U401.9 (P2_2); also elsewhere on the board
/Bluetooth/RXD: U401.28 (P0_5); also elsewhere on the board
/Bluetooth/VCC_BLE: C401.1, C402.1, C403.1, R401.1, U401.8 (AVDD), U401.17 (DVDD); also elsewhere on the board
/Control/BLE_RS: R401.2, U401.34 (RESET); also elsewhere on the board
/Control/RX: U401.29 (P0_4); also elsewhere on the board
GND: C401.2, C402.2, C403.2, U401.1 (GND), U401.2 (GND), U401.3 (GND), U401.4 (GND), U401.5 (GND), U401.6 (GND), U401.7 (GND), U401.18 (GND), U401.25 (GND), U401.36 (GND); also elsewhere on the board

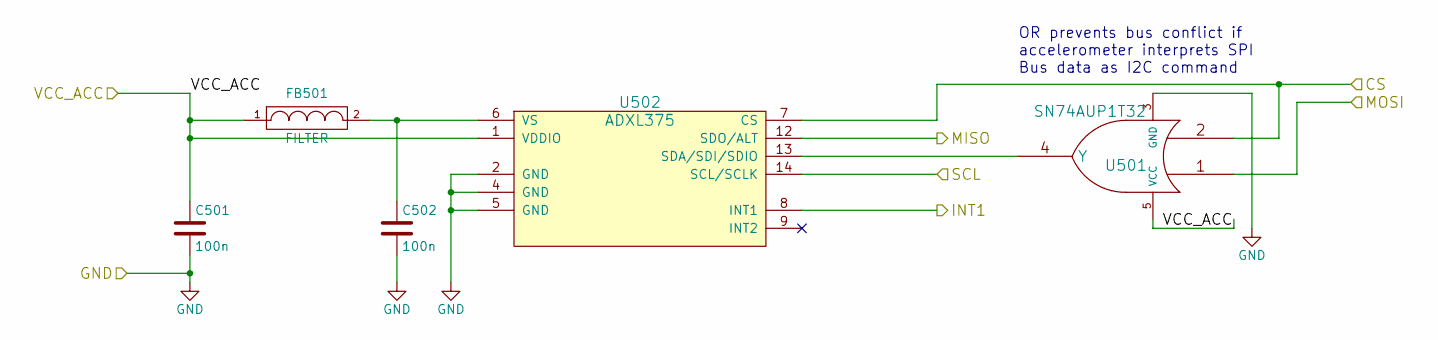
[picture p132: schematic sensor.sch, Energy harvesting sensor board with BLE radio]

Parts:
C501, C502: 100n; C_0603
FB501: FILTER; R_0603
U501: SN74AUP1T32; SOT-23-5
U502: ADXL375; LGA-14_(CC-14-1)

Connections:
/Control/INT0: U502.8 (INT1); also elsewhere on the board
/Control/MISO: U502.12 (SDO/ALT); also elsewhere on the board
/Control/MOSI: U501.1; also elsewhere on the board
/Control/SCK: U502.14 (SCL/SCLK); also elsewhere on the board
/Sensor/CS: U501.2, U502.7 (CS); also elsewhere on the board
/Sensor/VCC_ACC: C501.1, FB501.1, U501.5 (VCC), U502.1 (VDDIO); also elsewhere on the board
GND: C501.2, C502.2, U501.3 (GND), U502.2 (GND), U502.4 (GND), U502.5 (GND); also elsewhere on the board
unnamed: C502.1, FB501.2, U502.6 (VS)
unnamed: U501.4 (Y), U502.13 (SDA/SDI/SDIO)

Notes on the sheet:
OR prevents bus conflict if accelerometer interprets SPI Bus data as I2C command

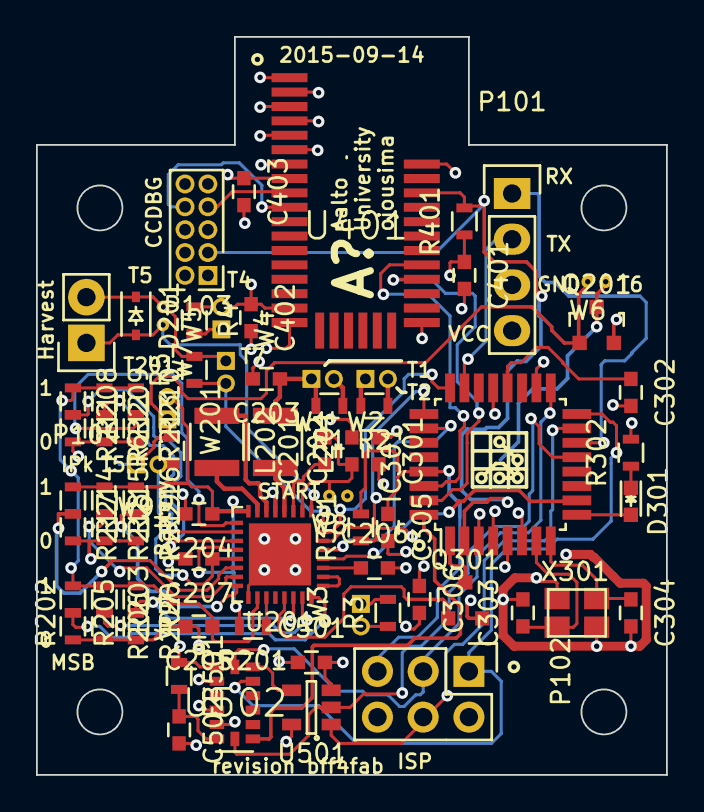
[picture p133: board radio.kicad_pcb from above]

Board: 4 copper layers, 35.0 x 41.0 mm, 74 parts (1 on the bottom side), 57 nets.

Other parts of the board:
W5: TEST; Test_pair_TH_tiny

Their connections:
/Power management/Harvest1: W5.2; also elsewhere on the board
/Power management/Harvest2: W5.1; also elsewhere on the board
