ojousima/thesis/(commit log)

2015-07-22 Add text on design materials
2015-07-23 Add image of LG equivalent circuit
2015-07-28 Add mass-spring-damper image
2015-08-20 Add tube magnet femm sim
2015-08-20 Single bias magnet
2015-08-20 Add force vs distance calculations, images
    [forcevsdistance.ods]
2015-08-20 Add text about FEA analysis of magnetic forces
    [forcevsdistance.ods]
2015-08-21 Add chapter about structure of tyre
2015-08-24 Add simulation data of flux linkage
    [linkagevsdistance.ods]
2015-08-31 Update design text
    [linkagevsdistance.ods]
2015-08-31 Add piezo test results and pictures of test setups
    [piezo_force_voltage.ods]
2015-08-31 Add Piexo MPPT schematic
    [mppt.sch, voltage_sink.sch]
2015-09-01 Add signaling LEDs to voltage clamps, adjust time constant on peak detect.
    [mppt.sch, voltage_sink.sch]
2015-09-01 Add piezo measurement simulation
    [piezo_force_voltage.ods]
2015-09-03 Add MPPT schematic capture
2015-09-05 Reduce complexity of MPPT schematic
    [mppt.sch]
2015-09-05 Add system schematics.
    [bluetooth.sch, controller.sch, harvester.sch, radio.sch, sensor.sch]
2015-09-05 Set simulation magnet to correct spot
2015-09-05 Associate footprints
    [radio.kicad_pcb]
2015-09-05 Draw PCB outline
    [radio.kicad_pcb]
2015-09-05 Add ATMEGA328 footprint
2015-09-05 Add radio footprint to PCB
    [radio.kicad_pcb]
2015-09-06 Add accelerometer to schematic
    [bluetooth.sch, controller.sch, harvester.sch, radio.kicad_pcb, radio.sch, sensor.sch]
2015-09-06 Add footprints for BLE113, battery, accelerometer
2015-09-06 Add KiCAD -bak files to gitignore
2015-09-06 Associate battery, BLE113, OR-gate, ADXL375 footprints
    [radio.kicad_pcb]
2015-09-07 Work on PCB
    [bluetooth.sch, controller.sch, harvester.sch, radio.kicad_pcb, radio.sch, sensor.sch]
2015-09-08 Start routing the PCB
    [radio.kicad_pcb]
2015-09-08 Fix the µC part number, pin numbering
    [bluetooth.sch, controller.sch, sensor.sch]
2015-09-08 Add KiCAD .bak -files to gitignore
2015-09-08 Add page descriptions to schematics
    [bluetooth.sch, controller.sch, harvester.sch, radio.sch, sensor.sch]
2015-09-11 Add test points for current and voltage
    [harvester.sch, radio.sch]
2015-09-13 Assign testpoint footprints
    [bluetooth.sch, controller.sch, harvester.sch, radio.kicad_pcb, radio.sch, sensor.sch]
2015-09-13 Work on laying out TPs
    [bluetooth.sch, controller.sch, harvester.sch, radio.sch, sensor.sch]
2015-09-13 Continue on TP layout
    [radio.kicad_pcb]
2015-09-13 Give sensor own power net
    [sensor.sch]
2015-09-13 Assign Q1 footprint
    [controller.sch, harvester.sch, radio.kicad_pcb]
2015-09-13 Create test point footprints
2015-09-13 Fix merge conflict on kicad-pcb
    [radio.kicad_pcb]
2015-09-13 Save before removing test points
    [radio.kicad_pcb]
2015-09-13 Parts placed
    [bluetooth.sch, controller.sch, harvester.sch, radio.kicad_pcb, radio.sch, sensor.sch]
2015-09-13 Work on layout
    [radio.kicad_pcb]
2015-09-13 Change inductor footprints to 1210
    [controller.sch, harvester.sch, radio.kicad_pcb]
2015-09-13 Routing finalized
    [bluetooth.sch, controller.sch, harvester.sch, radio.kicad_pcb, radio.sch, sensor.sch]
2015-09-13 Add revision information
    [harvester.sch]
2015-09-13 Shrink mounting holes to 2.5mm dia
    [radio.kicad_pcb]
2015-09-14 Add text on schematic design
2015-09-14 Add printout of bluetooth schematic
2015-09-14 Add text on circuit board layout
2015-09-14 compress schematic for embedding images in thesis
    [bluetooth.sch, harvester.sch]
2015-09-16 Compress schematics for printouts
    [controller.sch, sensor.sch]
2015-09-16 Add images of schematic and circuit
2015-09-16 Add printout of thesis
2015-09-16 Start work on laser cut pieces of generators
2015-09-17 Ignore gerber output
2015-09-17 Ignore KiCAD autosave file
2015-09-17 Ignore drill file
2015-09-17 Mechanical cuts for 10X15cm plate done
2015-09-22 Add active rectification circuit with boost
2015-09-28 Add matlab/SIMULINK block models
    [force.csv]
2015-10-07 Combine model
    [linkage.csv]
2015-10-14 Add graphs of measurement
    [piezo_force_voltage.ods]
2015-10-14 Add axes, combine accelerometer data figures
2015-10-15 Compress schematics for screenshots
    [bluetooth.sch, controller.sch, harvester.sch, sensor.sch]
2015-10-15 Add BoM
    [radio.csv]
2015-10-15 Fix centrifugal force calculation
    [forcevsdistance.ods]
2015-10-15 Edit images on background and design
    [forcevsdistance.ods]
2015-10-28 update printout
2015-11-25 Add LTSpice simulation of voltage doubler
2015-11-25 Update kicad project file
2015-12-17 Add images of PCB mounted in tyre
2016-01-17 Add section on circuit design
2016-01-18 Adjust images for print
2016-01-18 Add text on harvesting circuit electrical performance
2016-01-18 Add BQ25504 design files
    [bq25504.csv, bq25504.kicad_pcb, bq25504.sch, bq25504_Design_Help_V1_2.ods]
2016-02-07 Remove magnetostrictive from tech to explore in detail
2016-02-10 sync files after adding .gitaatributes
    [force.csv, linkage.csv]
